voltlog/VoltHub7/schematic_volthub7_revA.pdf

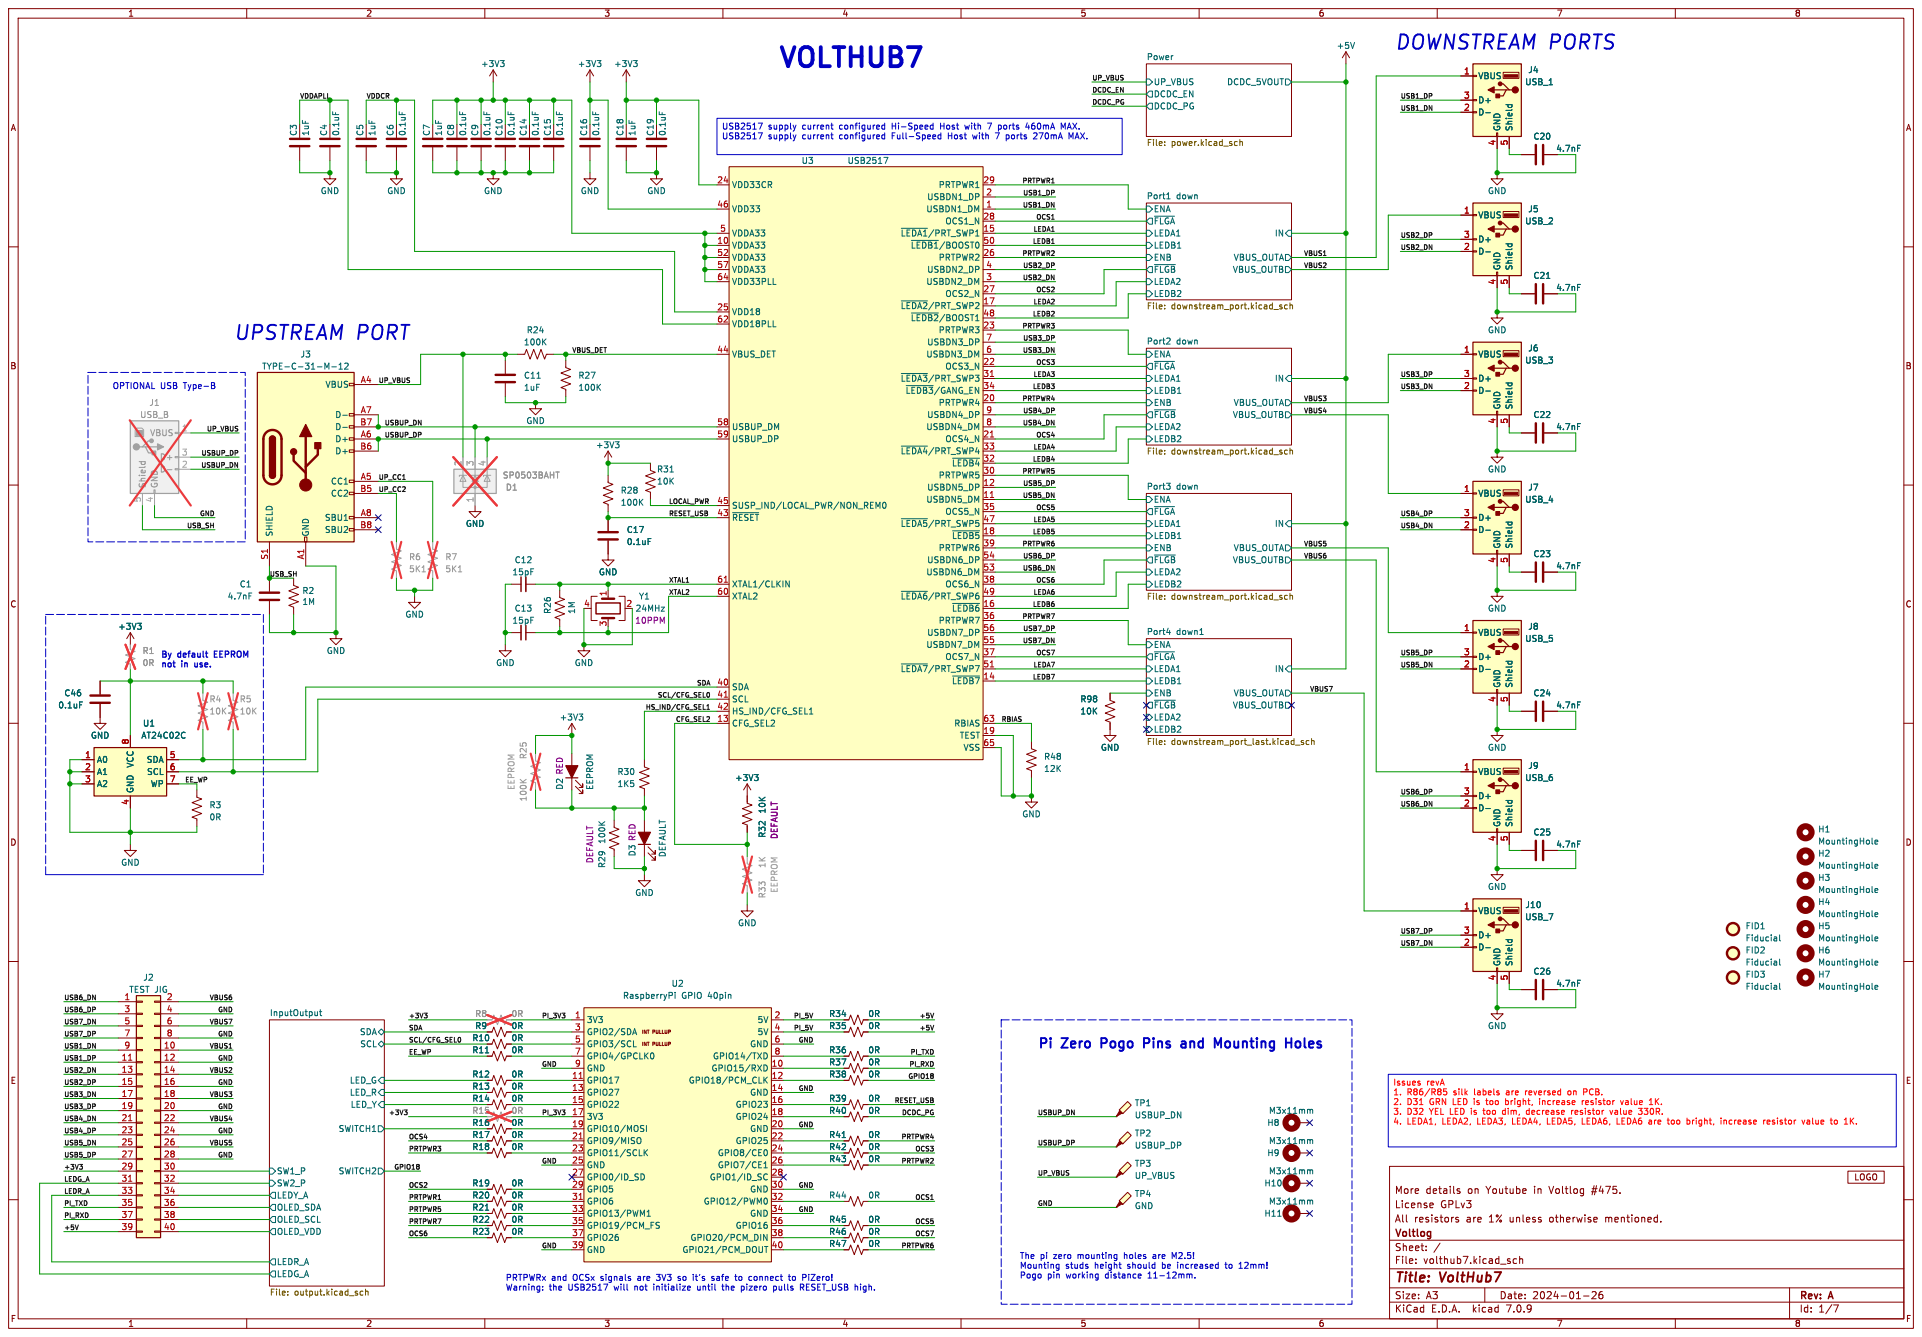
[picture p1: page 1]

DCDC_5VOUT Power File: power.kicad_sch ENA

4 SDA 5 SCL 6 WP 7 VCC

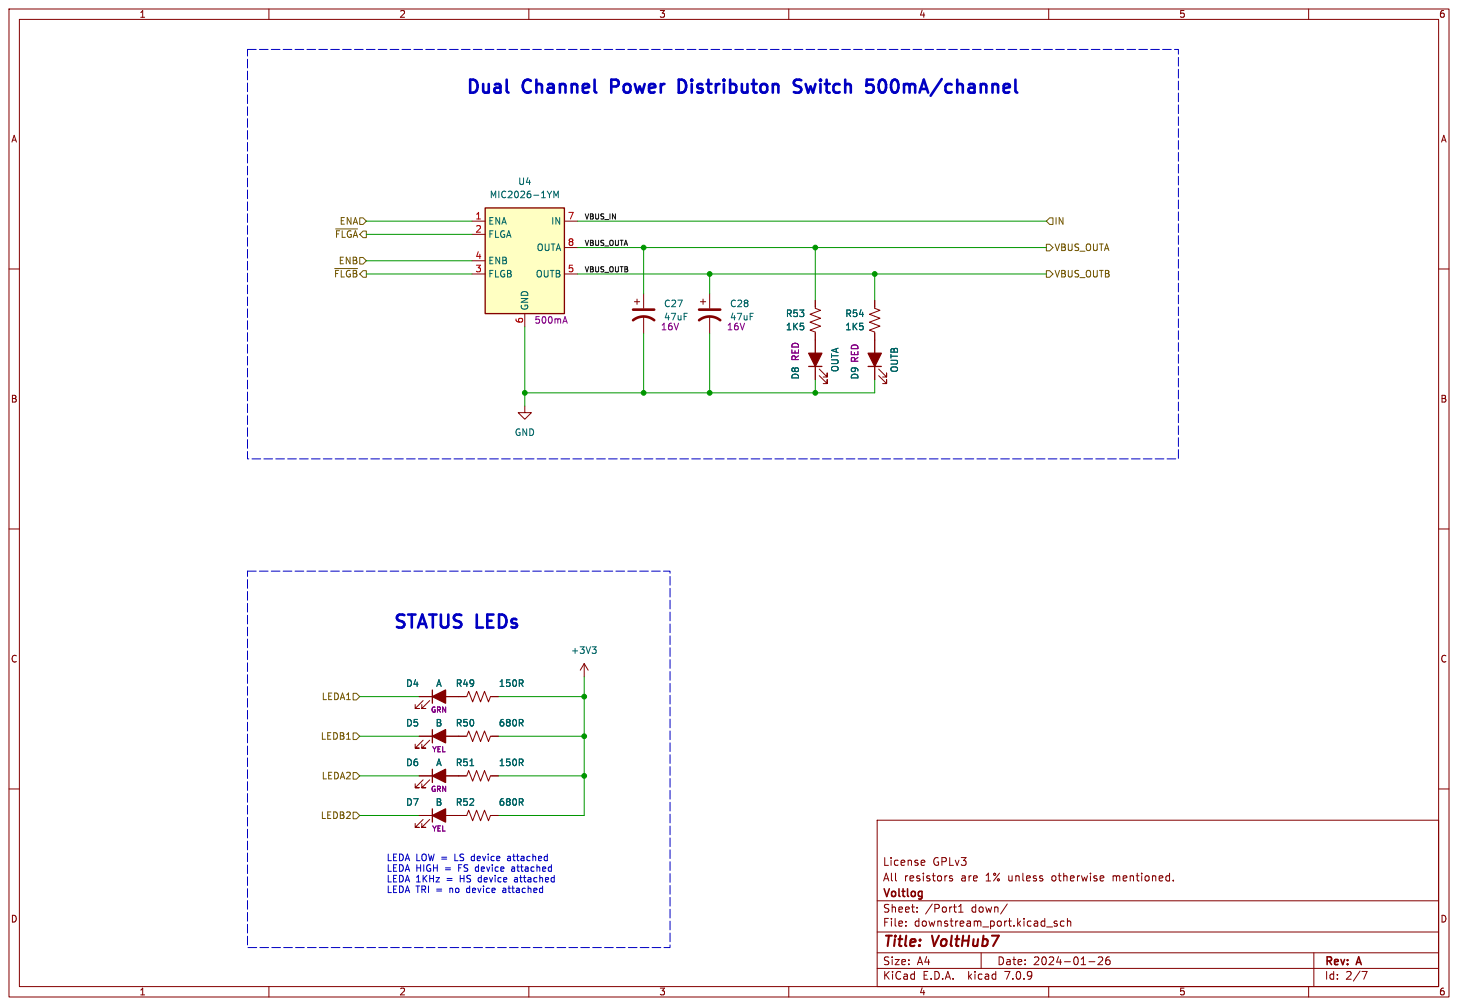
[picture p2: page 2]

LEDA LOW = LS device attached
LEDA HIGH = FS device attached
LEDA 1KHz = HS device attached

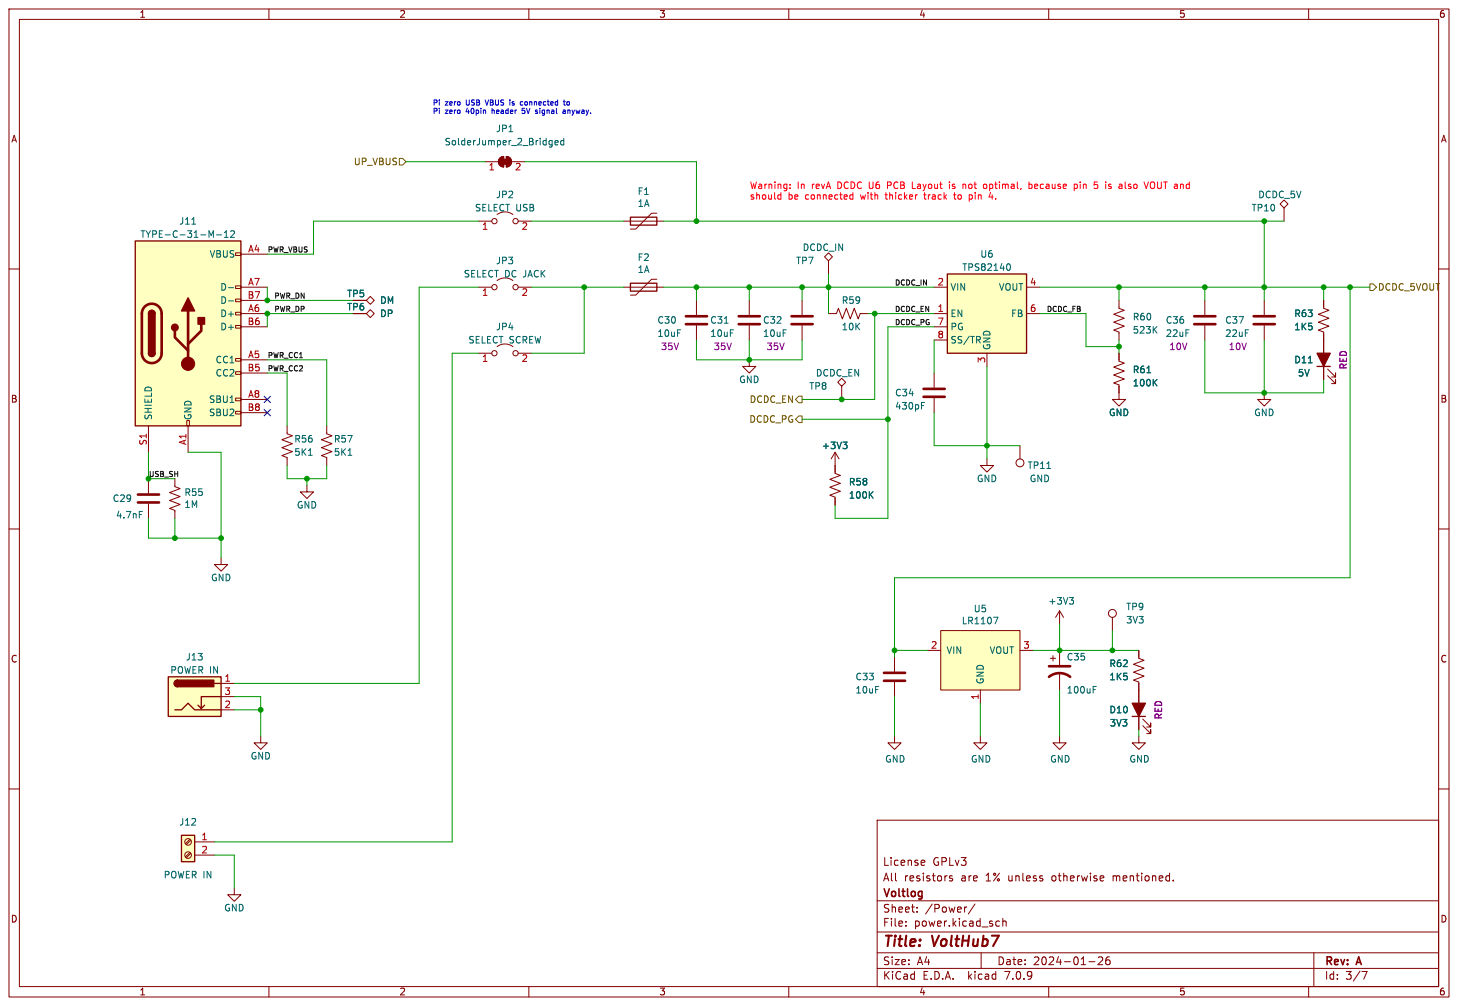
[picture p3: page 3]

3 VOUT 4 FB 6 PG 7 SS/TR 8 U6 TPS82140 R55

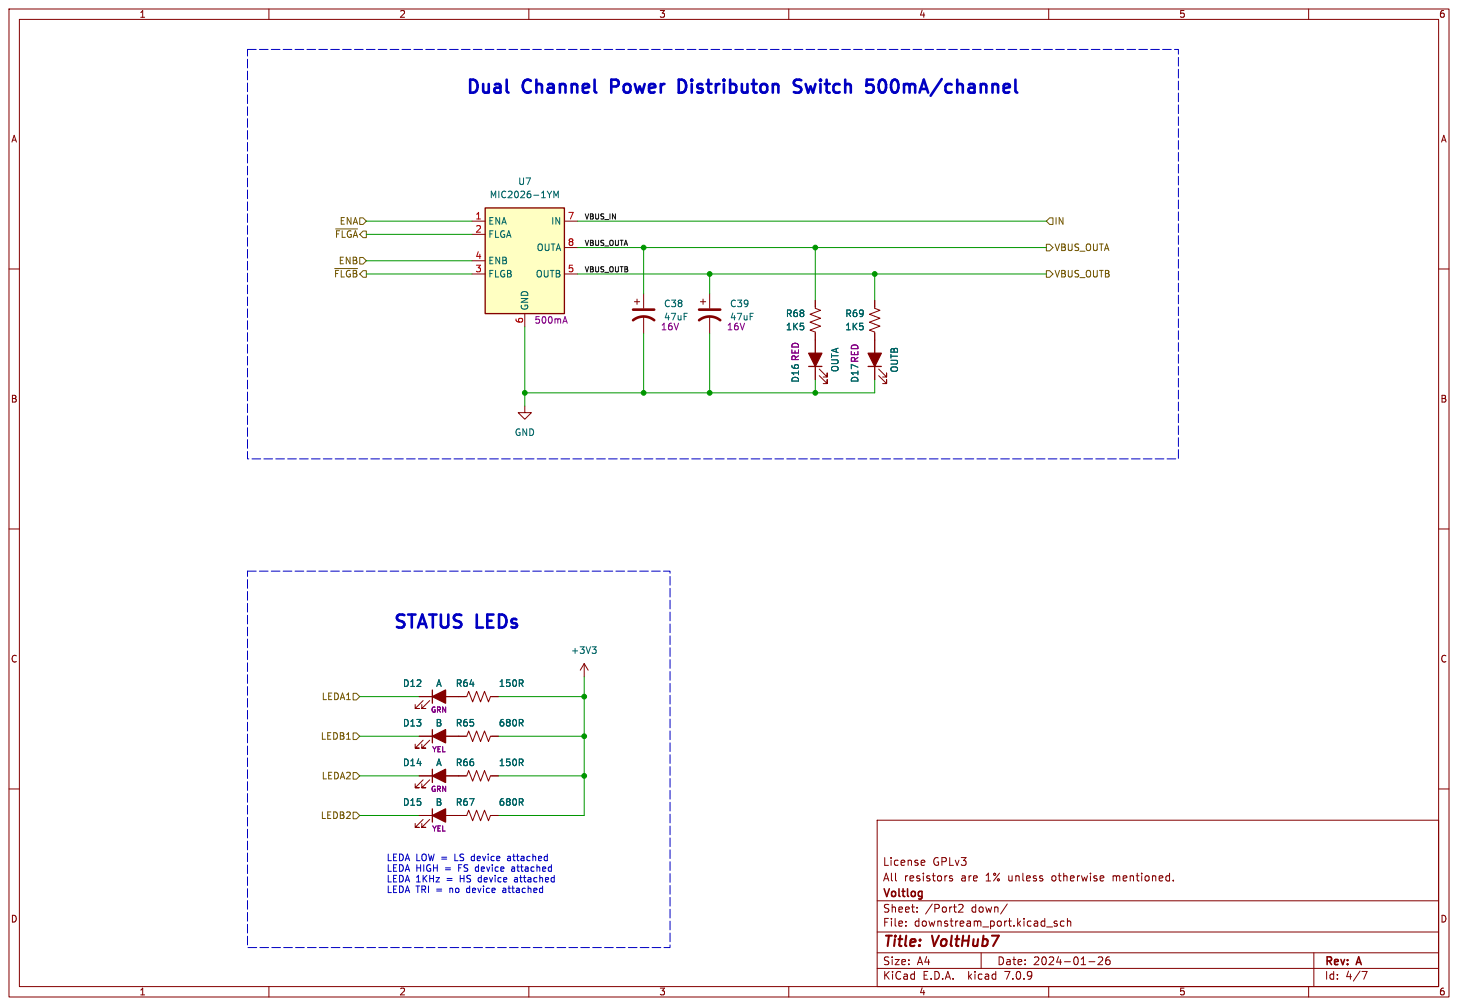
[picture p4: page 4]

LEDA LOW = LS device attached
LEDA HIGH = FS device attached
LEDA 1KHz = HS device attached

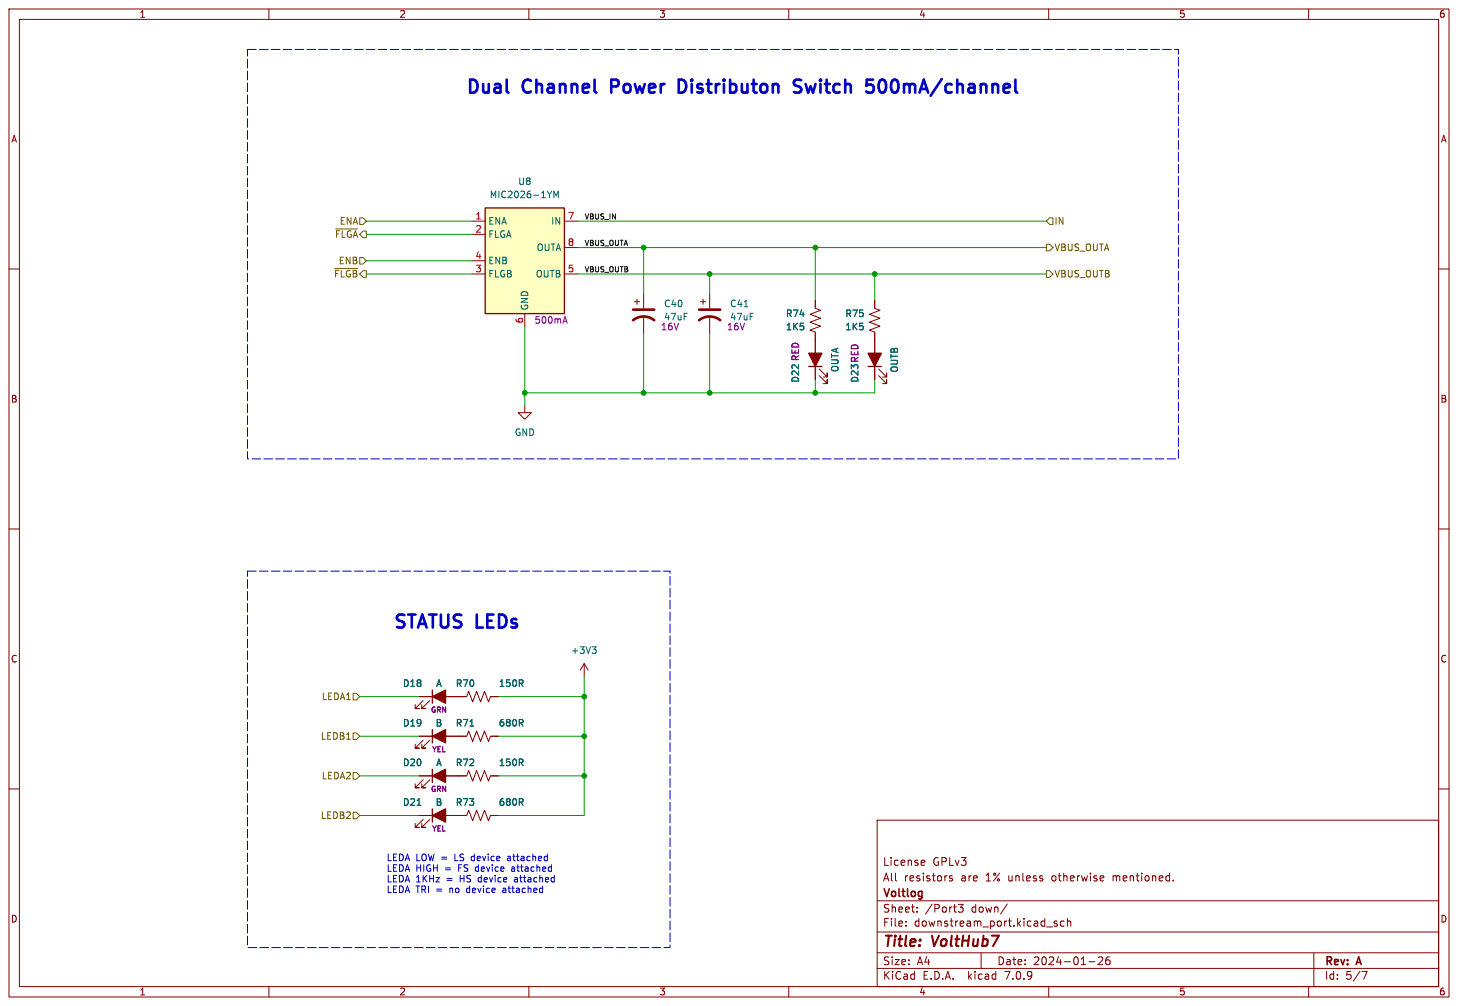
[picture p5: page 5]

LEDA LOW = LS device attached
LEDA HIGH = FS device attached
LEDA 1KHz = HS device attached

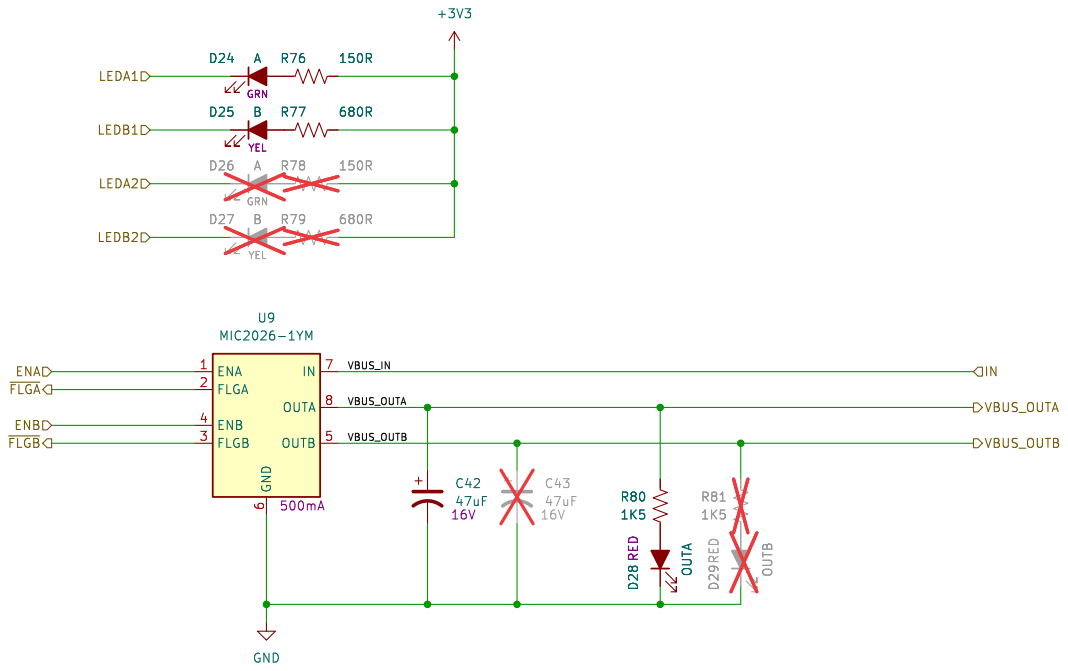
[picture p6: page 6]

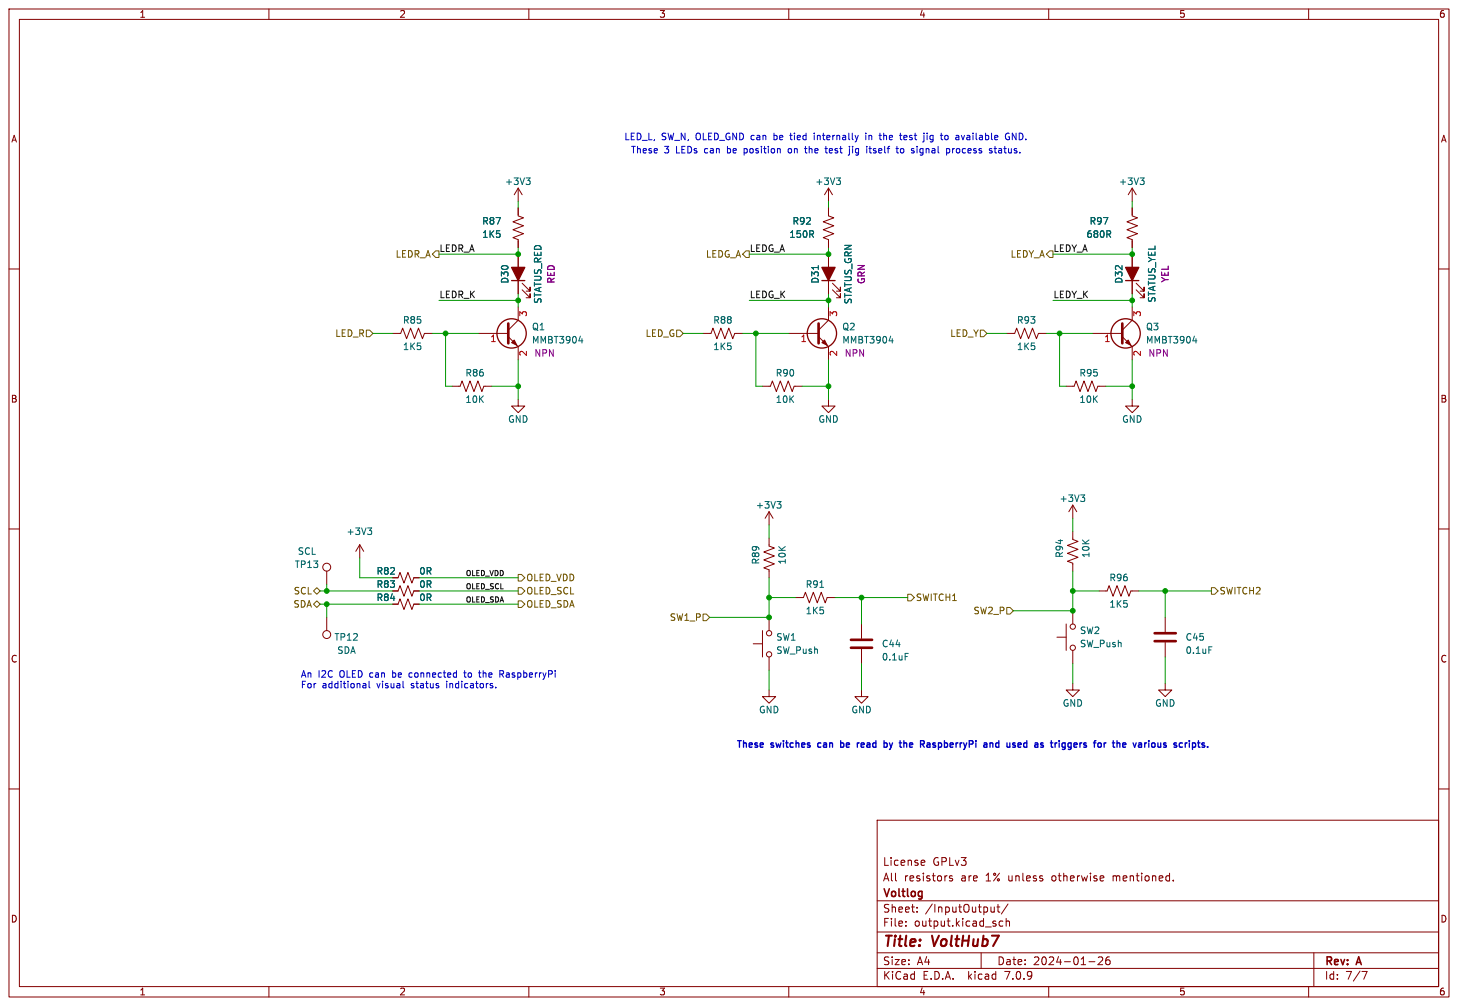
[picture p7: page 7]

File: output.kicad_sch Sheet: /InputOutput/
Id: 7/7 Title: VoltHub7
