voltlog/VoltHub7/volthub7.kicad_pcb

## KiCad design volthub7.kicad_pcb (2024-02-27)

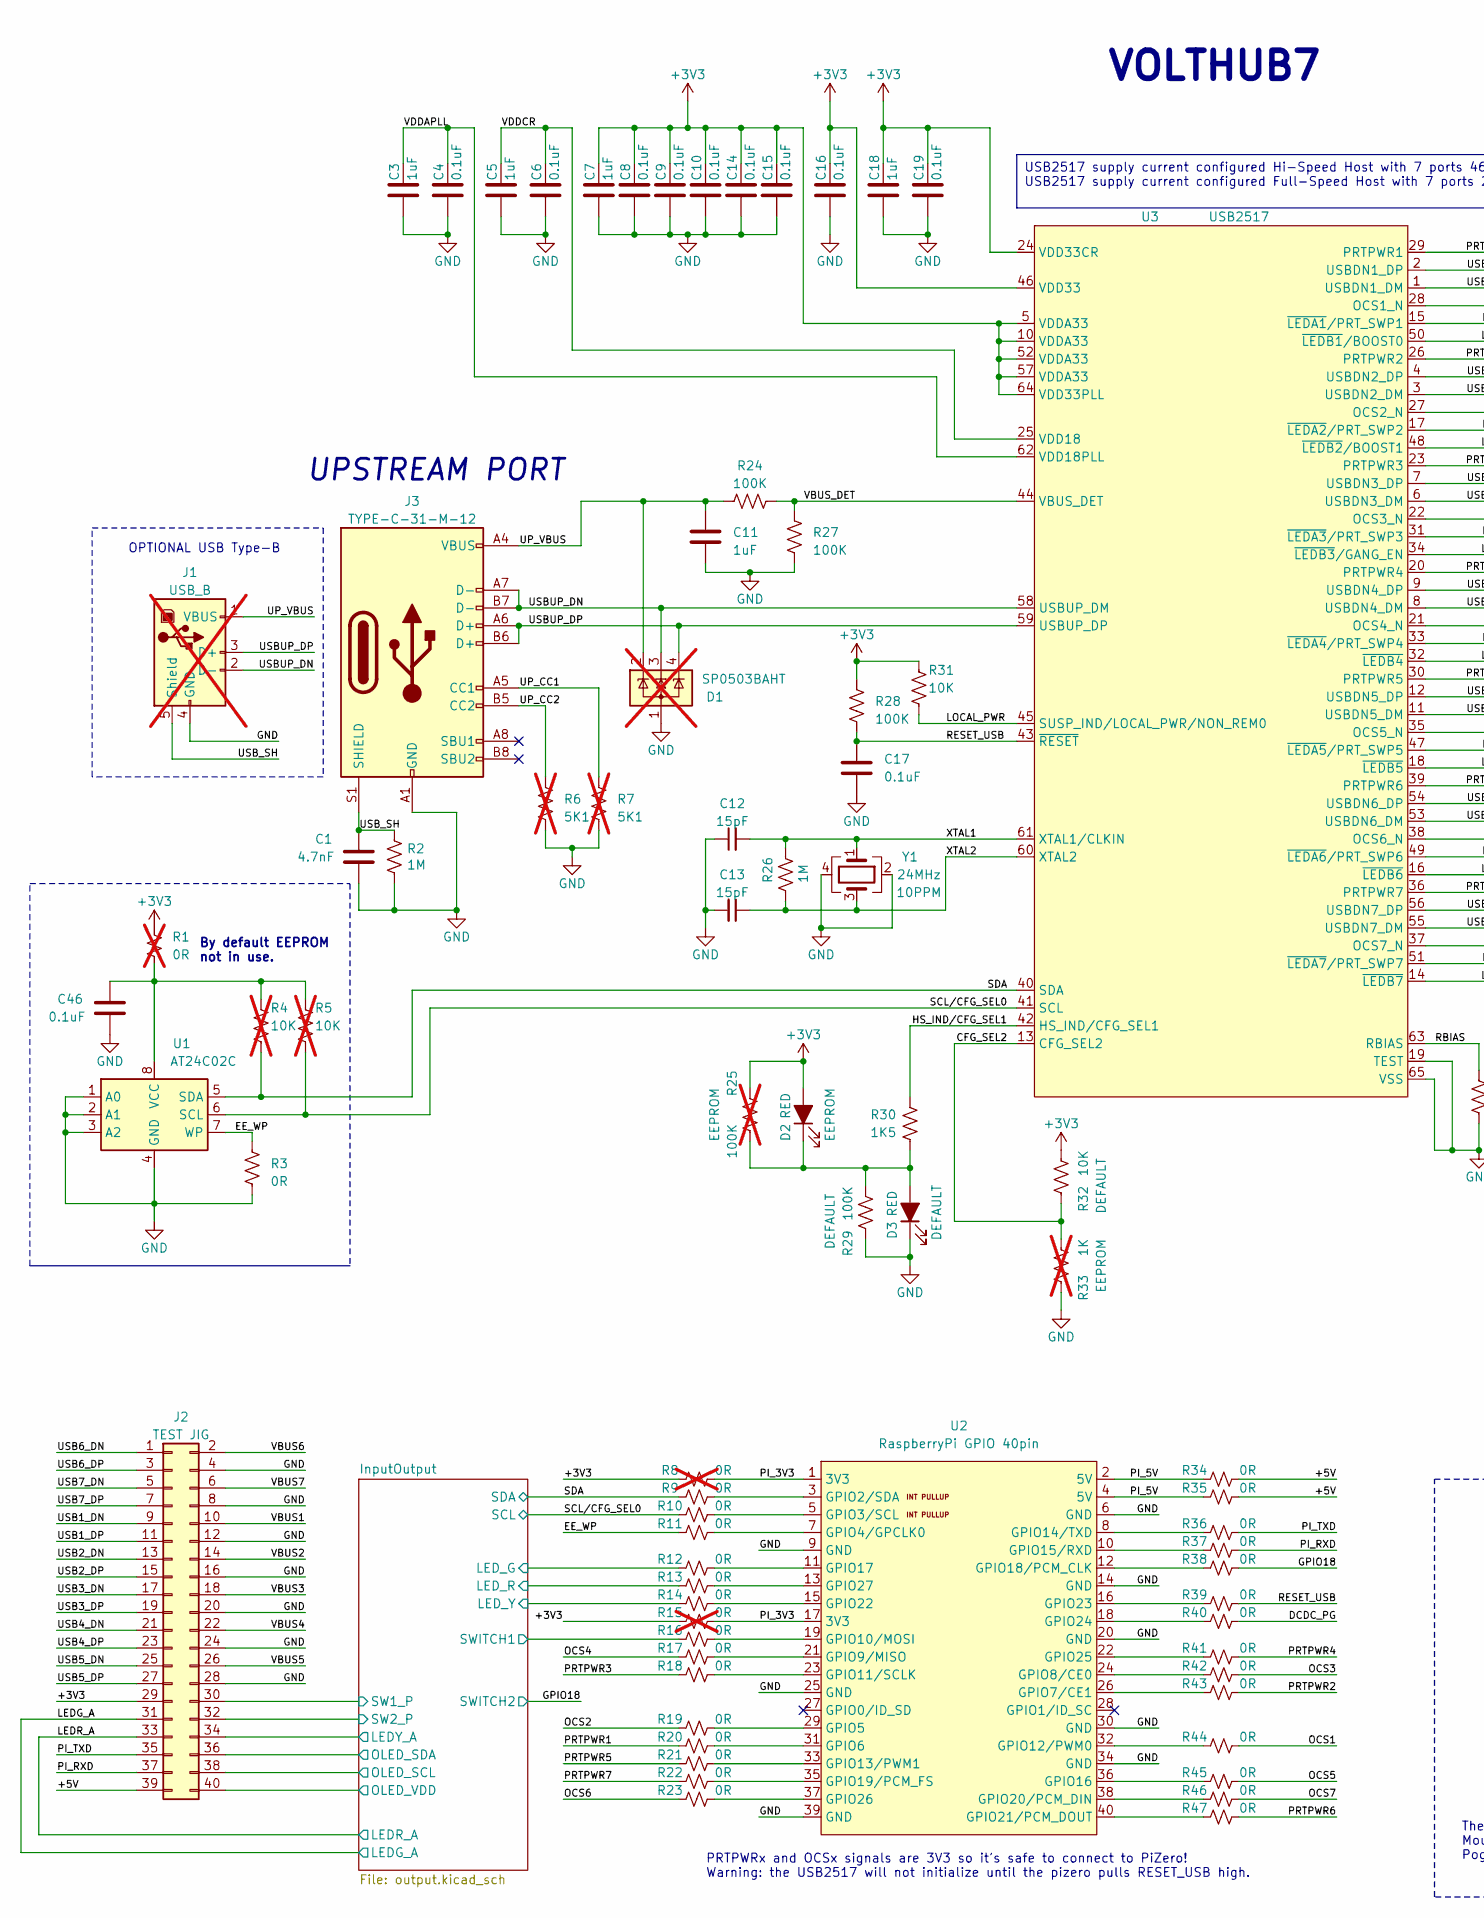
[picture p8: schematic volthub7.kicad_sch, part in row 1, column 1]

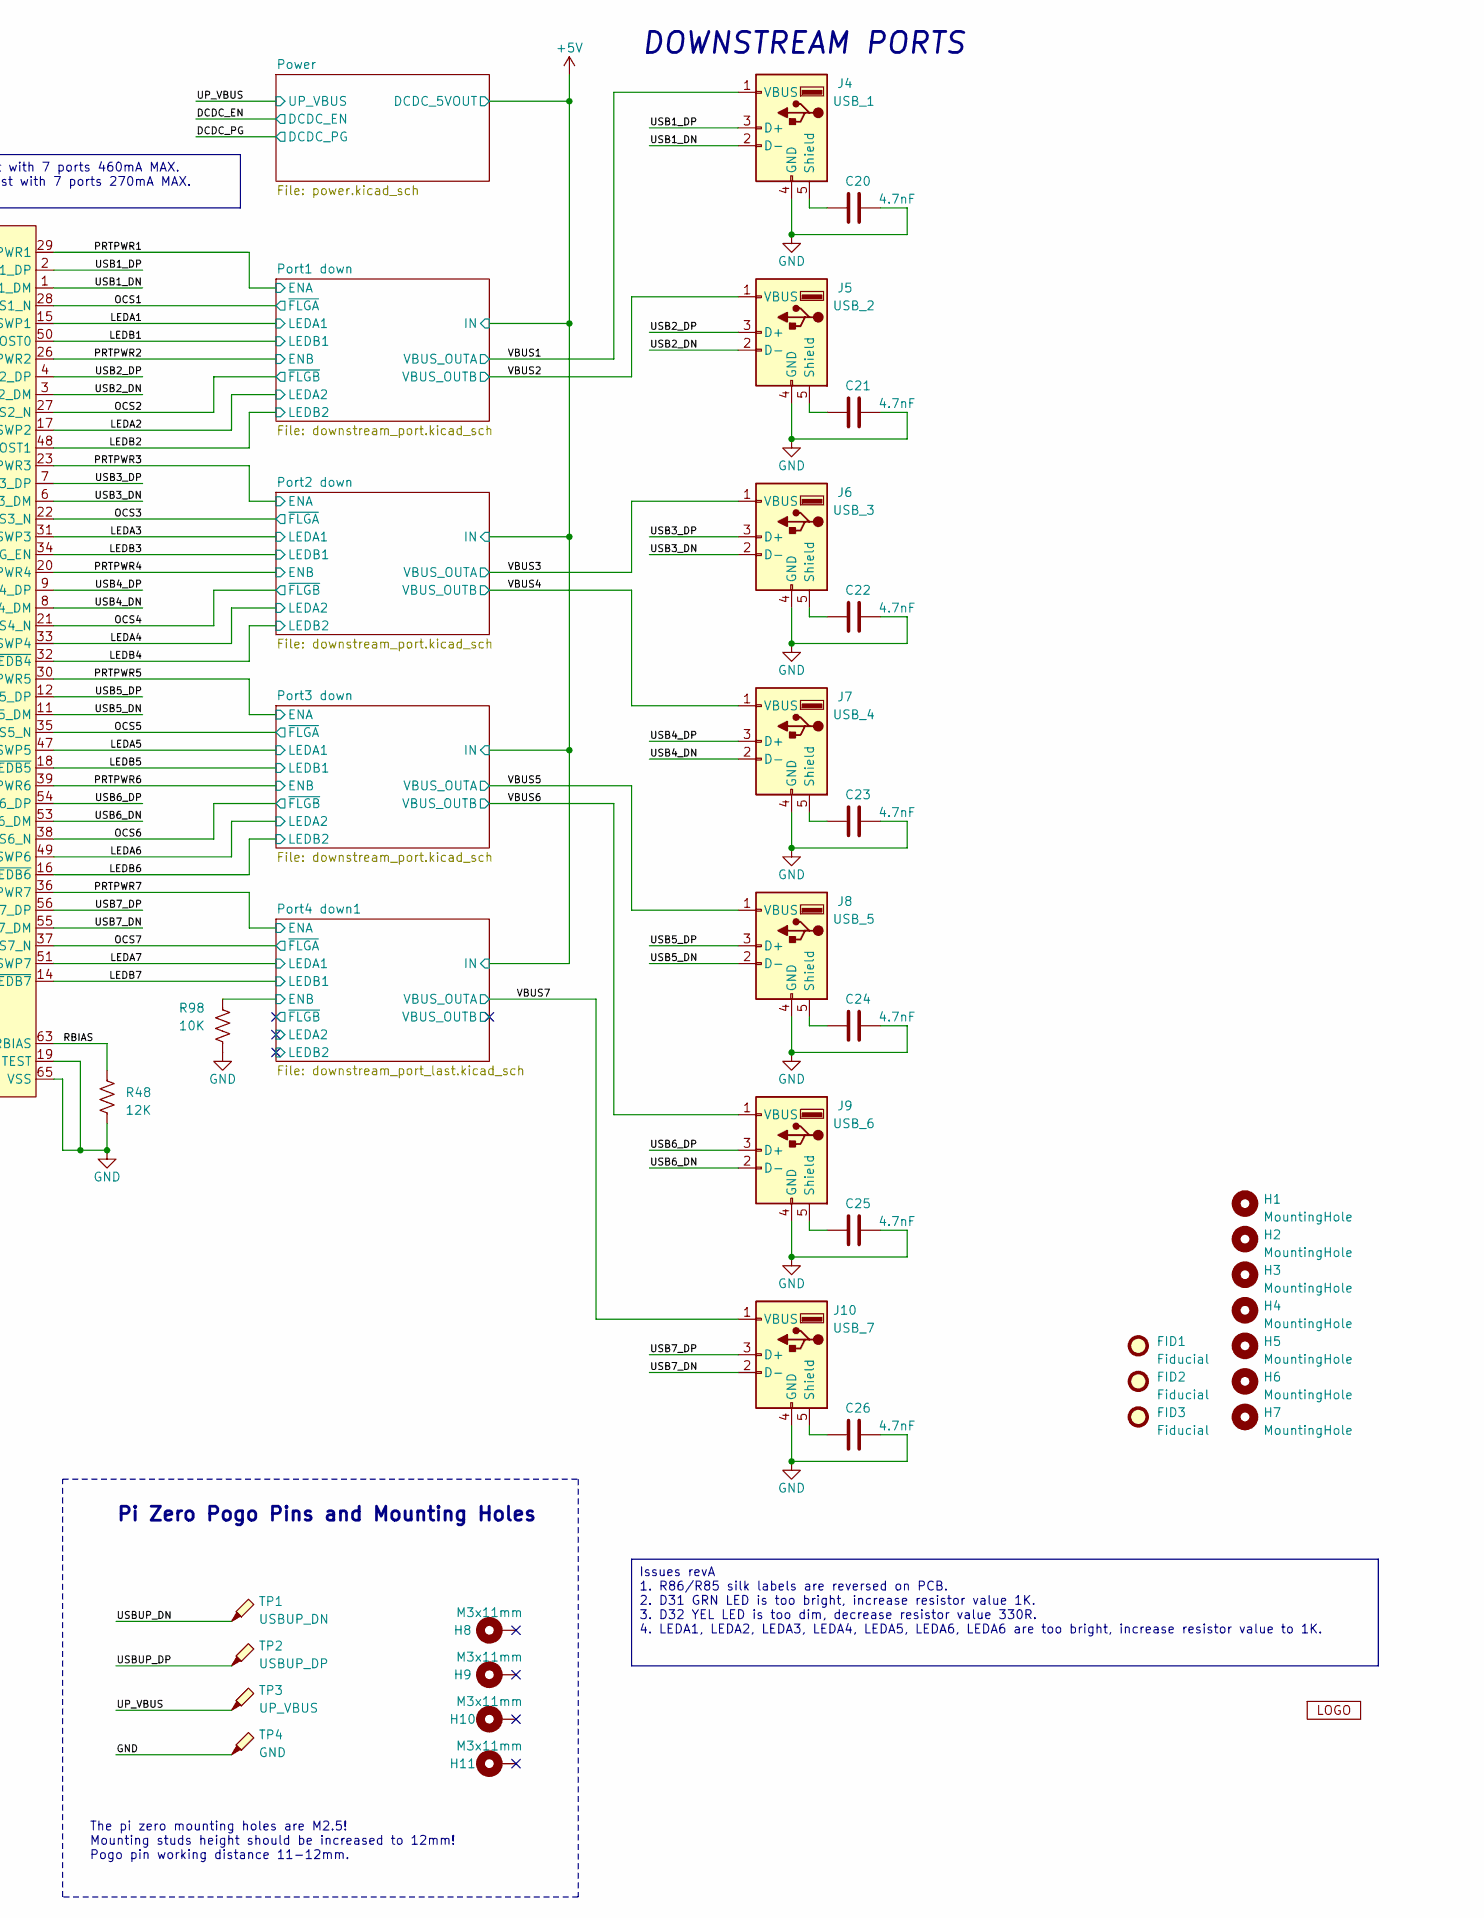
[picture p9: schematic volthub7.kicad_sch, part in row 1, column 2]

Parts:
C1: 4.7nF; C_1206_3216Metric; LCSC C107198
C3, C5, C7, C11, C18: 1uF; C_0603_1608Metric
C4, C6, C8, C9, C10, C14, C15, C16, C17, C19, C46: 0.1uF; C_0603_1608Metric; LCSC C14663
C12, C13: 15pF; C_0603_1608Metric; LCSC C1644
C20, C21, C22, C23, C24, C25, C26: 4.7nF; C_1206_3216Metric; LCSC C24497
D1: SP0503BAHT; SOT-143; LCSC C2682275; not fitted
D2: EEPROM; LED_0603_1608Metric; LCSC C193902
D3: DEFAULT; LED_0603_1608Metric; LCSC C193902
FID1, FID2, FID3: Fiducial; Fiducial_0.5mm_Mask1mm
H1, H2, H3, H4, H5, H6, H7: MountingHole; MountingHole_3.2mm_M3
H8, H9, H10, H11: M3x11mm; SMTSO30100CTJ; LCSC C2916372
J1: USB_B; USB_B_Lumberg_2411_02_Horizontal; LCSC C530600; not fitted
J2: TEST JIG; JST_PHD_B32B-PHDSS_2x20_P2.00mm_Vertical; LCSC C2845630
J3: TYPE-C-31-M-12; USB_C_Receptacle_HRO_TYPE-C-31-M-12; LCSC C165948
J4: USB_1; USB_A_HRO_U-A-24DD-W-5; LCSC C530625
J5: USB_2; USB_A_HRO_U-A-24DD-W-5; LCSC C530625
J6: USB_3; USB_A_HRO_U-A-24DD-W-5; LCSC C530625
J7: USB_4; USB_A_HRO_U-A-24DD-W-5; LCSC C530625
J8: USB_5; USB_A_HRO_U-A-24DD-W-5; LCSC C530625
J9: USB_6; USB_A_HRO_U-A-24DD-W-5; LCSC C530625
J10: USB_7; USB_A_HRO_U-A-24DD-W-5; LCSC C530625
R1, R8, R15: 0R; R_0603_1608Metric; LCSC C21189; not fitted
R2: 1M; R_1206_3216Metric
R3, R9, R10, R11, R12, R13, R14, R16, R17, R18, R19, R20, R21, R22, R23, R34, R35, R36, R37, R38, R39, R40, R41, R42, R43, R44, R45, R46, R47: 0R; R_0603_1608Metric; LCSC C21189
R4, R5: 10K; R_0603_1608Metric; LCSC C25804; not fitted
R6, R7: 5K1; R_0603_1608Metric; not fitted
R24, R27, R28, R29: 100K; R_0603_1608Metric; LCSC C25803
R25: 100K; R_0603_1608Metric; LCSC C25803; not fitted
R26: 1M; R_0603_1608Metric; LCSC C22935
R30: 1K5; R_0603_1608Metric; LCSC C21190
R31, R32, R98: 10K; R_0603_1608Metric; LCSC C25804
R33: 1K; R_0603_1608Metric; LCSC C21190; not fitted
R48: 12K; R_0603_1608Metric; LCSC C22790
TP1: USBUP_DN; Pogo_pin_YZ87615160P-01; LCSC C5157295
TP2: USBUP_DP; Pogo_pin_YZ87615160P-01; LCSC C5157295
TP3: UP_VBUS; Pogo_pin_YZ87615160P-01; LCSC C5157295
TP4: GND; Pogo_pin_YZ87615160P-01; LCSC C5157295
U1: AT24C02C; SOIC-8_3.9x4.9mm_P1.27mm; LCSC C6203
U2: RaspberryPi GPIO 40pin; RaspberryPi_Zero2W_40Pin
U3: USB2517; QFN-64-1EP_9x9mm_P0.5mm_EP4.7x4.7mm; LCSC C1521556
V1: VOLTLOG_LOGO; voltlog_mask_5mm
Y1: 24MHz; Crystal_SMD_SeikoEpson_TSX3225-4Pin_3.2x2.5mm; Tolerance 10PPM; LCSC C89577

Connections:
+3V3: C7.1, C8.1, C9.1, C10.1, C14.1, C15.1, C16.1, C18.1, C19.1, D2.2 (A), J2.29, R1.2, R8.1, R15.1, R25.1, R28.2, R31.2, R32.2, U3.5 (VDDA33), U3.10 (VDDA33), U3.24 (VDD33CR), U3.46 (VDD33), U3.52 (VDDA33), U3.57 (VDDA33), U3.64 (VDD33PLL); also elsewhere on the board
+5V: J2.39, R34.2, R35.2; also elsewhere on the board
/CFG_SEL2: R32.1, R33.2, U3.13 (CFG_SEL2)
/DCDC_PG: R40.2; also elsewhere on the board
/EE_WP: R3.2, R11.1, U1.7 (WP)
/GPIO18: R38.2; also elsewhere on the board
/HS_IND/CFG_SEL1: R30.2, U3.42 (HS_IND/CFG_SEL1)
/LEDA1: U3.15 (~LEDA1/PRT_SWP1); also elsewhere on the board
/LEDA2: U3.17 (~LEDA2/PRT_SWP2); also elsewhere on the board
/LEDA3: U3.31 (~LEDA3/PRT_SWP3); also elsewhere on the board
/LEDA4: U3.33 (~LEDA4/PRT_SWP4); also elsewhere on the board
/LEDA5: U3.47 (~LEDA5/PRT_SWP5); also elsewhere on the board
/LEDA6: U3.49 (~LEDA6/PRT_SWP6); also elsewhere on the board
/LEDA7: U3.51 (~LEDA7/PRT_SWP7); also elsewhere on the board
/LEDB1: U3.50 (~LEDB1/BOOST0); also elsewhere on the board
/LEDB2: U3.48 (~LEDB2/BOOST1); also elsewhere on the board
/LEDB3: U3.34 (~LEDB3/GANG_EN); also elsewhere on the board
/LEDB4: U3.32 (~LEDB4); also elsewhere on the board
/LEDB5: U3.18 (~LEDB5); also elsewhere on the board
/LEDB6: U3.16 (~LEDB6); also elsewhere on the board
/LEDB7: U3.14 (~LEDB7); also elsewhere on the board
/LEDG_A: J2.31; also elsewhere on the board
/LEDR_A: J2.33; also elsewhere on the board
/LOCAL_PWR: R31.1, U3.45 (SUSP_IND/LOCAL_PWR/NON_REM0)
/OCS1: R44.2, U3.28 (OCS1_N); also elsewhere on the board
/OCS2: R19.1, U3.27 (OCS2_N); also elsewhere on the board
/OCS3: R42.2, U3.22 (OCS3_N); also elsewhere on the board
/OCS4: R17.1, U3.21 (OCS4_N); also elsewhere on the board
/OCS5: R45.2, U3.35 (OCS5_N); also elsewhere on the board
/OCS6: R23.1, U3.38 (OCS6_N); also elsewhere on the board
/OCS7: R46.2, U3.37 (OCS7_N); also elsewhere on the board
/Output/LEDY_A: J2.34; also elsewhere on the board
/Output/LED_G: R12.1; also elsewhere on the board
/Output/LED_R: R13.1; also elsewhere on the board
/Output/LED_Y: R14.1; also elsewhere on the board
/Output/OLED_SCL: J2.38; also elsewhere on the board
/Output/OLED_SDA: J2.36; also elsewhere on the board
/Output/OLED_VDD: J2.40; also elsewhere on the board
/Output/SW1_P: J2.30; also elsewhere on the board
/Output/SW2_P: J2.32; also elsewhere on the board
/Output/SWITCH1: R16.1; also elsewhere on the board
/PI_3V3: R8.2, R15.2, U2.1 (3V3), U2.17 (3V3)
/PI_5V: R34.1, R35.1, U2.2 (5V), U2.4 (5V)
/PI_RXD: J2.37, R37.2
/PI_TXD: J2.35, R36.2
/PRTPWR1: R20.1, U3.29 (PRTPWR1); also elsewhere on the board
/PRTPWR2: R43.2, U3.26 (PRTPWR2); also elsewhere on the board
/PRTPWR3: R18.1, U3.23 (PRTPWR3); also elsewhere on the board
/PRTPWR4: R41.2, U3.20 (PRTPWR4); also elsewhere on the board
/PRTPWR5: R21.1, U3.30 (PRTPWR5); also elsewhere on the board
/PRTPWR6: R47.2, U3.39 (PRTPWR6); also elsewhere on the board
/PRTPWR7: R22.1, U3.36 (PRTPWR7); also elsewhere on the board
/Port4 down1/ENB: R98.2; also elsewhere on the board
/RBIAS: R48.2, U3.63 (RBIAS)
/RESET_USB: C17.1, R28.1, R39.2, U3.43 (~RESET)
/SCL/CFG_SEL0: R5.1, R10.1, U1.6 (SCL), U3.41 (SCL); also elsewhere on the board
/SDA: R4.1, R9.1, U1.5 (SDA), U3.40 (SDA); also elsewhere on the board
/UP_CC1: J3.A5 (CC1), R7.2
/UP_CC2: J3.B5 (CC2), R6.2
/UP_VBUS: C11.1, D1.2 (K), J1.1 (VBUS), J3.A4 (VBUS), J3.A9 (VBUS), J3.B4 (VBUS), J3.B9 (VBUS), R24.1, TP3.1; also elsewhere on the board
/USB1_DN: J2.9, J4.2 (D-), U3.1 (USBDN1_DM)
/USB1_DP: J2.11, J4.3 (D+), U3.2 (USBDN1_DP)
/USB2_DN: J2.13, J5.2 (D-), U3.3 (USBDN2_DM)
/USB2_DP: J2.15, J5.3 (D+), U3.4 (USBDN2_DP)
/USB3_DN: J2.17, J6.2 (D-), U3.6 (USBDN3_DM)
/USB3_DP: J2.19, J6.3 (D+), U3.7 (USBDN3_DP)
/USB4_DN: J2.21, J7.2 (D-), U3.8 (USBDN4_DM)
/USB4_DP: J2.23, J7.3 (D+), U3.9 (USBDN4_DP)
/USB5_DN: J2.25, J8.2 (D-), U3.11 (USBDN5_DM)
/USB5_DP: J2.27, J8.3 (D+), U3.12 (USBDN5_DP)
/USB6_DN: J2.1, J9.2 (D-), U3.53 (USBDN6_DM)
/USB6_DP: J2.3, J9.3 (D+), U3.54 (USBDN6_DP)
/USB7_DN: J2.5, J10.2 (D-), U3.55 (USBDN7_DM)
/USB7_DP: J2.7, J10.3 (D+), U3.56 (USBDN7_DP)
/USBUP_DN: D1.3 (K), J1.2 (D-), J3.A7 (D-), J3.B7 (D-), TP1.1, U3.58 (USBUP_DM)
/USBUP_DP: D1.4 (K), J1.3 (D+), J3.A6 (D+), J3.B6 (D+), TP2.1, U3.59 (USBUP_DP)
/VBUS1: J2.10, J4.1 (VBUS); also elsewhere on the board
/VBUS2: J2.14, J5.1 (VBUS); also elsewhere on the board
/VBUS3: J2.18, J6.1 (VBUS); also elsewhere on the board
/VBUS4: J2.22, J7.1 (VBUS); also elsewhere on the board
/VBUS5: J2.26, J8.1 (VBUS); also elsewhere on the board
/VBUS6: J2.2, J9.1 (VBUS); also elsewhere on the board
/VBUS7: J2.6, J10.1 (VBUS); also elsewhere on the board
/VBUS_DET: R24.2, R27.2, U3.44 (VBUS_DET)
/VDDAPLL: C3.1, C4.1, U3.62 (VDD18PLL)
/VDDCR: C5.1, C6.1, U3.25 (VDD18)
/XTAL1: C12.2, R26.2, U3.61 (XTAL1/CLKIN), Y1.1
/XTAL2: C13.1, R26.1, U3.60 (XTAL2), Y1.3
GND: C1.2, C3.2, C4.2, C5.2, C6.2, C7.2, C8.2, C9.2, C10.2, C11.2, C12.1, C13.2, C14.2, C15.2, C16.2, C17.2, C18.2, C19.2, C20.2, C21.2, C22.2, C23.2, C24.2, C25.2, C26.2, D1.1 (A), D3.1 (K), J1.4 (GND), J2.4, J2.8, J2.12, J2.16, J2.20, J2.24, J2.28, J3.A1 (GND), J3.A12 (GND), J3.B1 (GND), J3.B12 (GND), J4.4 (GND), J5.4 (GND), J6.4 (GND), J7.4 (GND), J8.4 (GND), J9.4 (GND), J10.4 (GND), R2.2, R3.1, R6.1, R7.1, R27.1, R29.2, R33.1, R48.1, R98.1, TP4.1, U1.1 (A0), U1.2 (A1), U1.3 (A2), U1.4 (GND), U2.6 (GND), U2.9 (GND), U2.14 (GND), U2.20 (GND), U2.25 (GND), U2.30 (GND), U2.34 (GND), U2.39 (GND), U3.19 (TEST), U3.65 (VSS), Y1.2, Y1.4; also elsewhere on the board
unnamed: D2.1 (K), D3.2 (A), R25.2, R29.1, R30.1
unnamed: C20.1, J4.5 (Shield)
unnamed: C21.1, J5.5 (Shield)
unnamed: C22.1, J6.5 (Shield)
unnamed: C23.1, J7.5 (Shield)
unnamed: C24.1, J8.5 (Shield)
unnamed: C25.1, J9.5 (Shield)
unnamed: C26.1, J10.5 (Shield)
unnamed: R9.2, U2.3 (GPIO2/SDA)
unnamed: R10.2, U2.5 (GPIO3/SCL)
unnamed: R11.2, U2.7 (GPIO4/GPCLK0)
unnamed: R19.2, U2.29 (GPIO5)
unnamed: R20.2, U2.31 (GPIO6)
unnamed: R43.1, U2.26 (GPIO7/CE1)
unnamed: R42.1, U2.24 (GPIO8/CE0)
unnamed: R17.2, U2.21 (GPIO9/MISO)
unnamed: R16.2, U2.19 (GPIO10/MOSI)
unnamed: R18.2, U2.23 (GPIO11/SCLK)
unnamed: R44.1, U2.32 (GPIO12/PWM0)
unnamed: R21.2, U2.33 (GPIO13/PWM1)
unnamed: R36.1, U2.8 (GPIO14/TXD)
unnamed: R37.1, U2.10 (GPIO15/RXD)
unnamed: R45.1, U2.36 (GPIO16)
unnamed: R12.2, U2.11 (GPIO17)
unnamed: R38.1, U2.12 (GPIO18/PCM_CLK)
unnamed: R22.2, U2.35 (GPIO19/PCM_FS)
unnamed: R46.1, U2.38 (GPIO20/PCM_DIN)
unnamed: R47.1, U2.40 (GPIO21/PCM_DOUT)
unnamed: R14.2, U2.15 (GPIO22)
unnamed: R39.1, U2.16 (GPIO23)
unnamed: R40.1, U2.18 (GPIO24)
unnamed: R41.1, U2.22 (GPIO25)
unnamed: R23.2, U2.37 (GPIO26)
unnamed: R13.2, U2.13 (GPIO27)

Notes on the sheet:
USB2517 supply current configured Hi-Speed Host with 7 ports 460mA MAX. USB2517 supply current configured Full-Speed Host with 7 ports 270mA MAX.
Issues revA 1. R86/R85 silk labels are reversed on PCB. 2. D31 GRN LED is too bright, increase resistor value 1K. 3. D32 YEL LED is too dim, decrease resistor value 330R. 4. LEDA1, LEDA2, LEDA3, LEDA4, LEDA5, LEDA6, LEDA6 are too bright, increase resistor value to 1K.
The pi zero mounting holes are M2.5! Mounting studs height should be increased to 12mm! Pogo pin working distance 11-12mm.
PRTPWRx and OCSx signals are 3V3 so it's safe to connect to PiZero! Warning: the USB2517 will not initialize until the pizero pulls RESET_USB high.
OPTIONAL USB Type-B
UPSTREAM PORT
VOLTHUB7
By default EEPROM not in use.
Pi Zero Pogo Pins and Mounting Holes
DOWNSTREAM PORTS

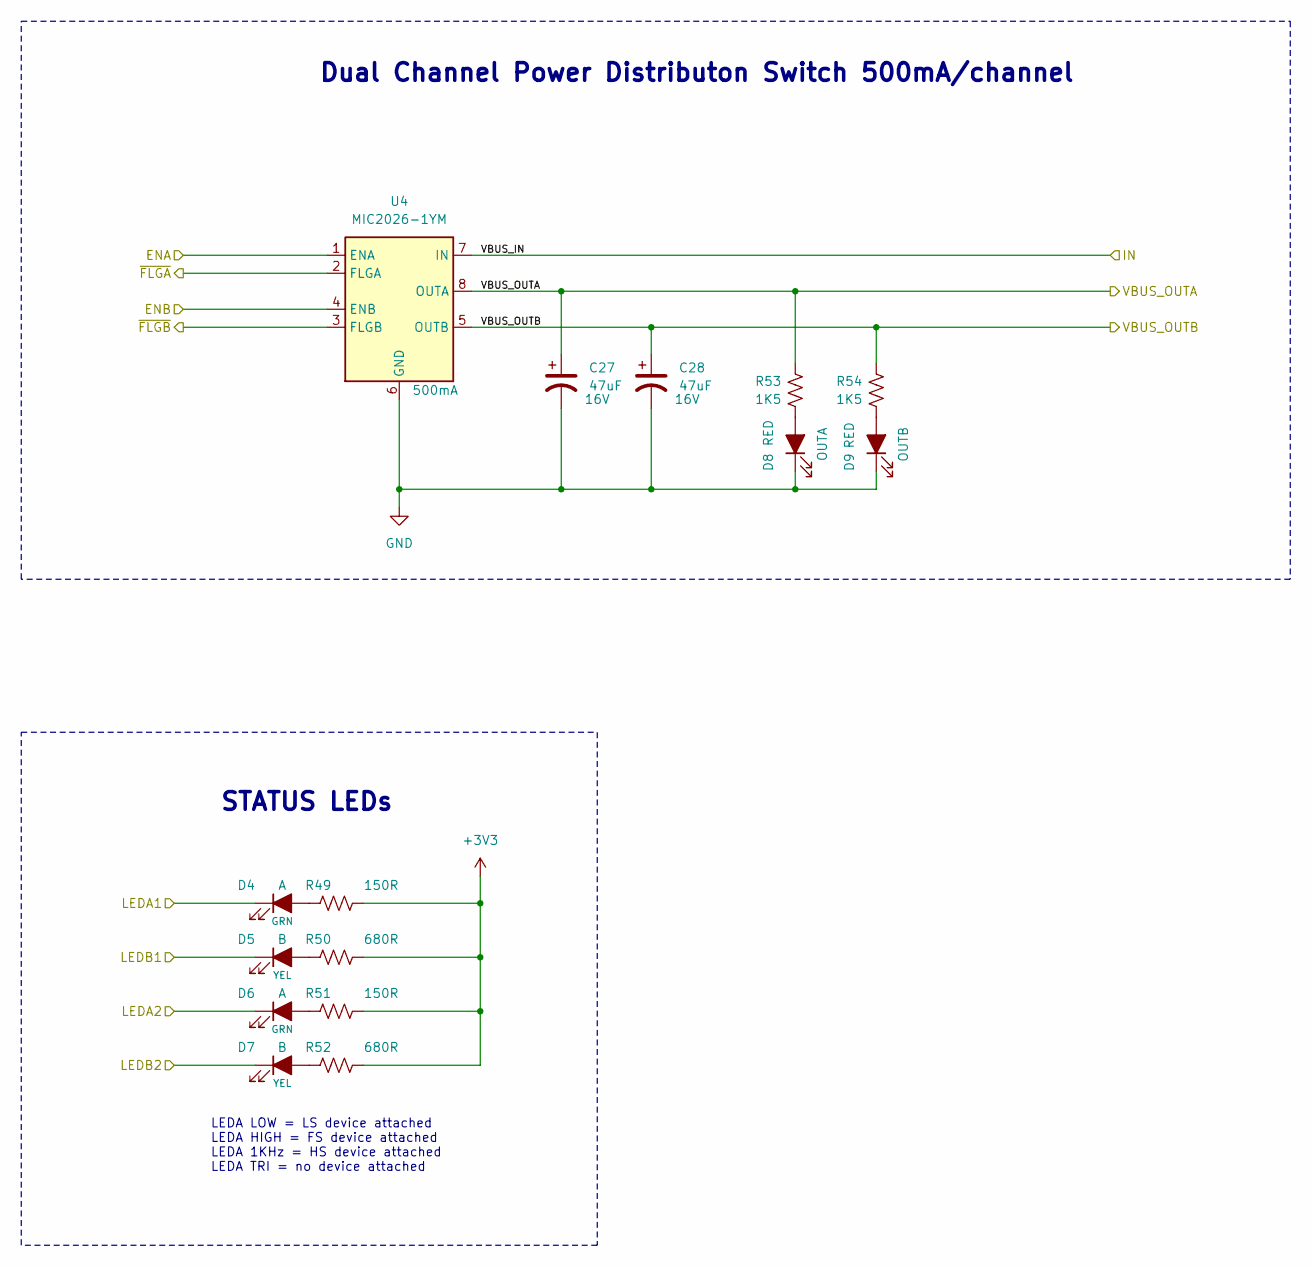
[picture p10: schematic downstream_port.kicad_sch, VoltHub7]

Parts:
C27, C28: 47uF; CP_Elec_6.3x5.3; Voltage 16V; LCSC C249535
D4, D6: A; LED_0603_1608Metric; LCSC C84267
D5, D7: B; LED_0603_1608Metric; LCSC C84268
D8: OUTA; LED_0603_1608Metric; LCSC C193902
D9: OUTB; LED_0603_1608Metric; LCSC C193902
R49, R51: 150R; R_0603_1608Metric; LCSC C22808
R50, R52: 680R; R_0603_1608Metric; LCSC C23228
R53, R54: 1K5; R_0603_1608Metric
U4: MIC2026-1YM; SO-8_3.9x4.9mm_P1.27mm; LCSC C144190

Connections:
+3V3: R49.2, R50.2, R51.2, R52.2; also elsewhere on the board
+5V: U4.7 (IN); also elsewhere on the board
/LEDA1: D4.1 (K); also elsewhere on the board
/LEDA2: D6.1 (K); also elsewhere on the board
/LEDB1: D5.1 (K); also elsewhere on the board
/LEDB2: D7.1 (K); also elsewhere on the board
/OCS1: U4.2 (FLGA); also elsewhere on the board
/OCS2: U4.3 (FLGB); also elsewhere on the board
/PRTPWR1: U4.1 (ENA); also elsewhere on the board
/PRTPWR2: U4.4 (ENB); also elsewhere on the board
/VBUS1: C27.1, R53.2, U4.8 (OUTA); also elsewhere on the board
/VBUS2: C28.1, R54.2, U4.5 (OUTB); also elsewhere on the board
GND: C27.2, C28.2, D8.1 (K), D9.1 (K), U4.6 (GND); also elsewhere on the board
unnamed: D4.2 (A), R49.1
unnamed: D5.2 (A), R50.1
unnamed: D6.2 (A), R51.1
unnamed: D7.2 (A), R52.1
unnamed: D8.2 (A), R53.1
unnamed: D9.2 (A), R54.1

Parts of its further copies:
C38, C39, C40, C41: 47uF; CP_Elec_6.3x5.3; Voltage 16V; LCSC C249535
D12, D14, D18, D20: A; LED_0603_1608Metric; LCSC C84267
D13, D15, D19, D21: B; LED_0603_1608Metric; LCSC C84268
D16, D22: OUTA; LED_0603_1608Metric; LCSC C193902
D17, D23: OUTB; LED_0603_1608Metric; LCSC C193902
R64, R66, R70, R72: 150R; R_0603_1608Metric; LCSC C22808
R65, R67, R71, R73: 680R; R_0603_1608Metric; LCSC C23228
R68, R69, R74, R75: 1K5; R_0603_1608Metric
U7, U8: MIC2026-1YM; SO-8_3.9x4.9mm_P1.27mm; LCSC C144190

Connections of its further copies:
+3V3: R64.2, R65.2, R66.2, R67.2, R70.2, R71.2, R72.2, R73.2; also elsewhere on the board
+5V: U7.7 (IN), U8.7 (IN); also elsewhere on the board
/LEDA3: D12.1 (K); also elsewhere on the board
/LEDA4: D14.1 (K); also elsewhere on the board
/LEDA5: D18.1 (K); also elsewhere on the board
/LEDA6: D20.1 (K); also elsewhere on the board
/LEDB3: D13.1 (K); also elsewhere on the board
/LEDB4: D15.1 (K); also elsewhere on the board
/LEDB5: D19.1 (K); also elsewhere on the board
/LEDB6: D21.1 (K); also elsewhere on the board
/OCS3: U7.2 (FLGA); also elsewhere on the board
/OCS4: U7.3 (FLGB); also elsewhere on the board
/OCS5: U8.2 (FLGA); also elsewhere on the board
/OCS6: U8.3 (FLGB); also elsewhere on the board
/PRTPWR3: U7.1 (ENA); also elsewhere on the board
/PRTPWR4: U7.4 (ENB); also elsewhere on the board
/PRTPWR5: U8.1 (ENA); also elsewhere on the board
/PRTPWR6: U8.4 (ENB); also elsewhere on the board
/VBUS3: C38.1, R68.2, U7.8 (OUTA); also elsewhere on the board
/VBUS4: C39.1, R69.2, U7.5 (OUTB); also elsewhere on the board
/VBUS5: C40.1, R74.2, U8.8 (OUTA); also elsewhere on the board
/VBUS6: C41.1, R75.2, U8.5 (OUTB); also elsewhere on the board
GND: C38.2, C39.2, C40.2, C41.2, D16.1 (K), D17.1 (K), D22.1 (K), D23.1 (K), U7.6 (GND), U8.6 (GND); also elsewhere on the board
unnamed: D12.2 (A), R64.1
unnamed: D13.2 (A), R65.1
unnamed: D14.2 (A), R66.1
unnamed: D15.2 (A), R67.1
unnamed: D16.2 (A), R68.1
unnamed: D17.2 (A), R69.1
unnamed: D18.2 (A), R70.1
unnamed: D19.2 (A), R71.1
unnamed: D20.2 (A), R72.1
unnamed: D21.2 (A), R73.1
unnamed: D22.2 (A), R74.1
unnamed: D23.2 (A), R75.1

Notes on the sheet:
Dual Channel Power Distributon Switch 500mA/channel
STATUS LEDs
LEDA LOW = LS device attached LEDA HIGH = FS device attached LEDA 1KHz = HS device attached LEDA TRI = no device attached

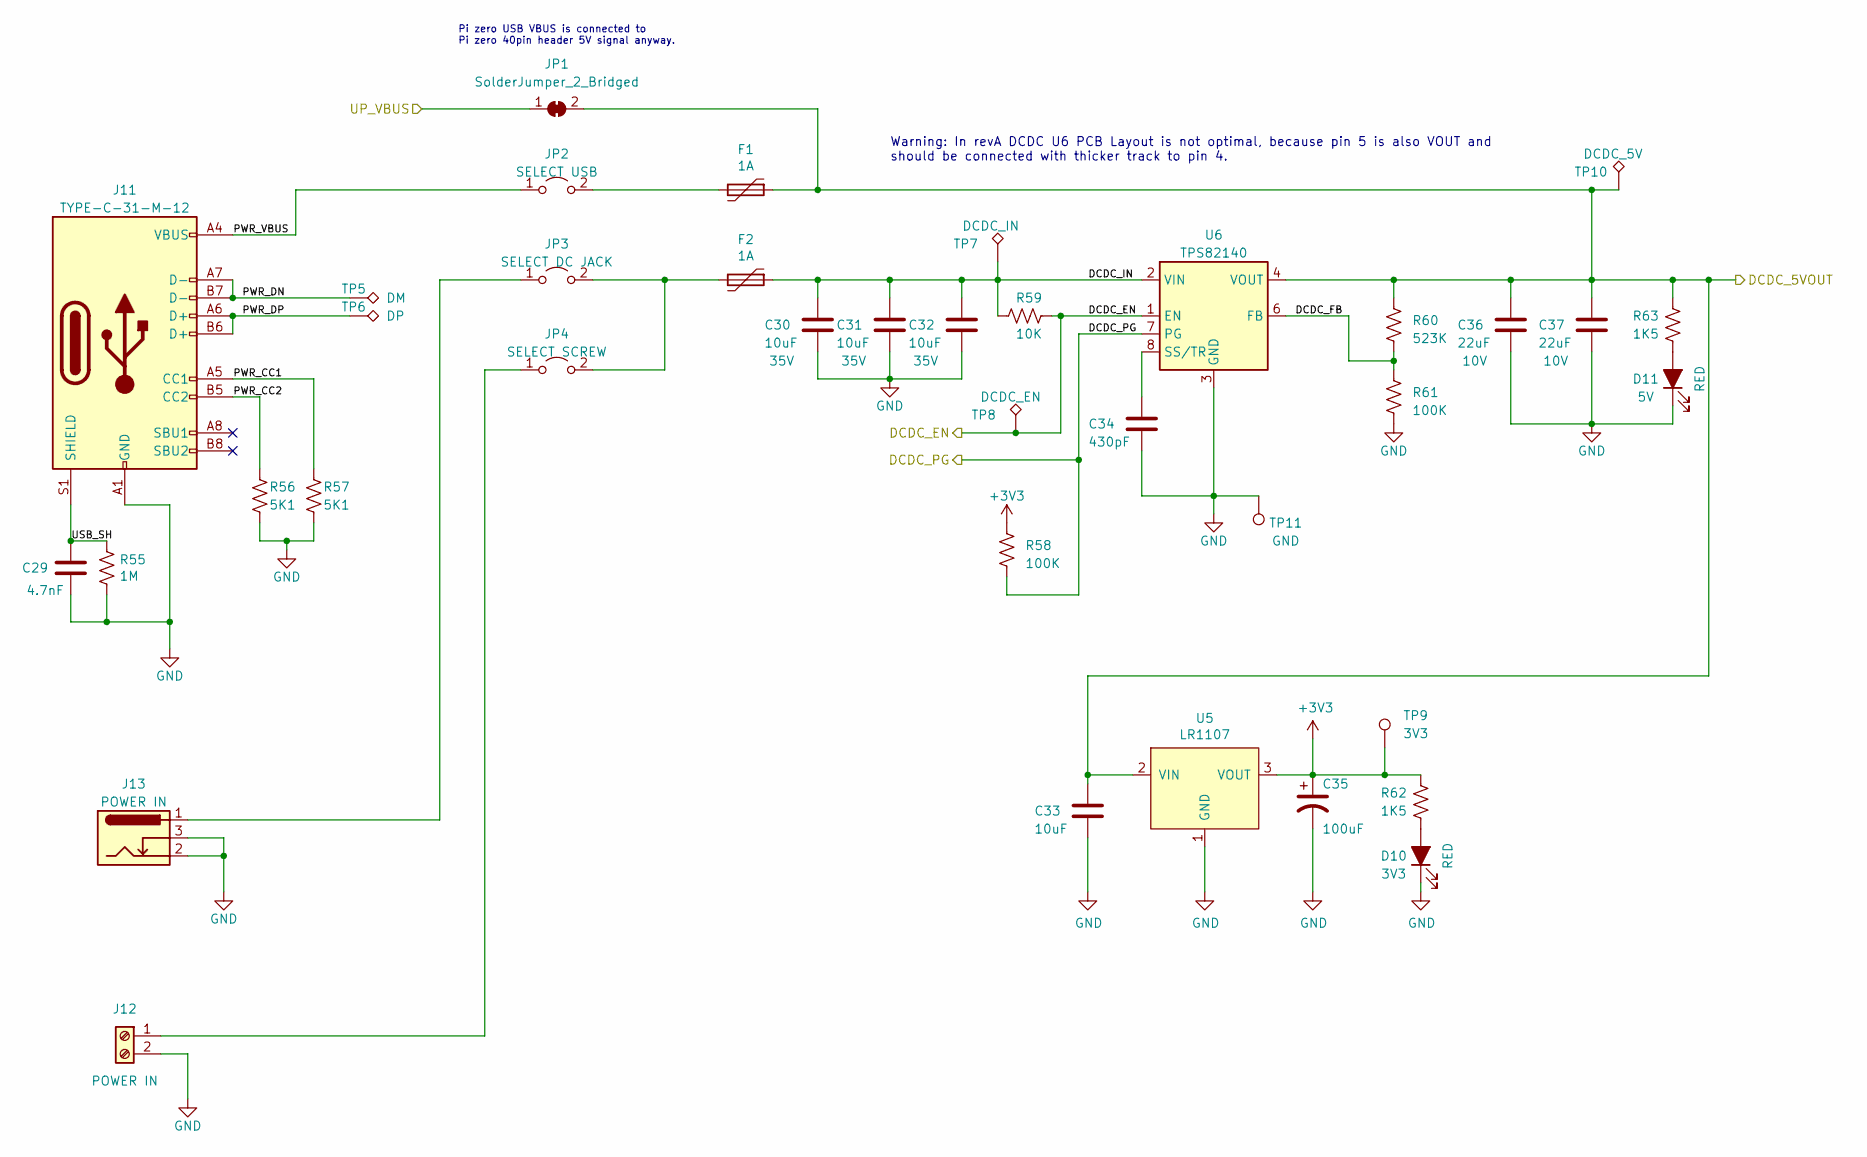
[picture p11: schematic power.kicad_sch, VoltHub7]

Parts:
C29: 4.7nF; C_1206_3216Metric; LCSC C107198
C30, C31, C32, C33: 10uF; C_0805_2012Metric; Voltage 35V; LCSC C162422
C34: 430pF; C_0603_1608Metric; LCSC C309472
C35: 100uF; CP_Elec_6.3x5.8; Voltage 10V; LCSC C340720
C36, C37: 22uF; C_0805_2012Metric; Voltage 10V; LCSC C29277
D10: 3V3; LED_0603_1608Metric; LCSC C193902
D11: 5V; LED_0603_1608Metric; LCSC C193902
F1, F2: 1A; Fuse_0805_2012Metric; LCSC C369152
J11: TYPE-C-31-M-12; USB_C_Receptacle_HRO_TYPE-C-31-M-12; LCSC C165948
J12: POWER IN; TerminalBlock_RND_205-00287_1x02_P5.08mm_Horizontal
J13: POWER IN; BarrelJack_CLIFF_FC681465S_SMT_Horizontal; LCSC C2987414
JP1: SolderJumper_2_Bridged; SolderJumper-2_P1.3mm_Bridged_RoundedPad1.0x1.5mm
JP2: SELECT USB; PinHeader_1x02_P2.54mm_Vertical
JP3: SELECT DC JACK; PinHeader_1x02_P2.54mm_Vertical
JP4: SELECT SCREW; PinHeader_1x02_P2.54mm_Vertical
R55: 1M; R_1206_3216Metric
R56, R57: 5K1; R_0603_1608Metric
R58, R61: 100K; R_0603_1608Metric; LCSC C25803
R59: 10K; R_0603_1608Metric; LCSC C25804
R60: 523K; R_0603_1608Metric; LCSC C5126197
R62: 1K5; R_0603_1608Metric; LCSC C21190
R63: 1K5; R_0603_1608Metric
TP5: DM; TestPoint_Pad_D1.0mm
TP6: DP; TestPoint_Pad_D1.0mm
TP7: DCDC_IN; TestPoint_Pad_D1.0mm
TP8: DCDC_EN; TestPoint_Pad_D1.0mm
TP9: 3V3; TestPoint_Pad_D1.0mm
TP10: DCDC_5V; TestPoint_Pad_D1.0mm
TP11: GND; TestPoint_Keystone_5019_Minature; LCSC C238131
U5: LR1107; SOT-89-3; LCSC C171498
U6: TPS82140; Texas_SIL0008D_MicroSiP-8-1EP_2.8x3mm_P0.65mm_EP1.1x1.9mm

Connections:
+3V3: C35.1, R58.2, R62.2, TP9.1, U5.3 (VOUT); also elsewhere on the board
+5V: C33.1, C36.1, C37.1, F1.1, JP1.2 (B), R60.2, R63.2, TP10.1, U5.2 (VIN), U6.4 (VOUT), U6.5 (VOUT); also elsewhere on the board
/DCDC_EN: R59.1, TP8.1, U6.1 (EN)
/DCDC_PG: R58.1, U6.7 (PG); also elsewhere on the board
/Power/DCDC_FB: R60.1, R61.2, U6.6 (FB)
/Power/DCDC_IN: C30.1, C31.1, C32.1, F2.1, R59.2, TP7.1, U6.2 (VIN)
/Power/PWR_CC1: J11.A5 (CC1), R57.2
/Power/PWR_CC2: J11.B5 (CC2), R56.2
/Power/PWR_DN: J11.A7 (D-), J11.B7 (D-), TP5.1
/Power/PWR_DP: J11.A6 (D+), J11.B6 (D+), TP6.1
/Power/PWR_VBUS: J11.A4 (VBUS), J11.A9 (VBUS), J11.B4 (VBUS), J11.B9 (VBUS), JP2.1 (A)
/Power/USB_SH: C29.1, J11.S1 (SHIELD), R55.1
/UP_VBUS: JP1.1 (A); also elsewhere on the board
GND: C29.2, C30.2, C31.2, C32.2, C33.2, C34.2, C35.2, C36.2, C37.2, D10.1 (K), D11.1 (K), J11.A1 (GND), J11.A12 (GND), J11.B1 (GND), J11.B12 (GND), J12.2, J13.2, J13.3, R55.2, R56.1, R57.1, R61.1, TP11.1, U5.1 (GND), U6.3 (GND), U6.9 (GND); also elsewhere on the board
unnamed: D10.2 (A), R62.1
unnamed: D11.2 (A), R63.1
unnamed: J12.1, JP4.1 (A)
unnamed: F1.2, JP2.2 (B)
unnamed: J13.1, JP3.1 (A)
unnamed: F2.2, JP3.2 (B), JP4.2 (B)
unnamed: C34.1, U6.8 (SS/TR)

Notes on the sheet:
Pi zero USB VBUS is connected to Pi zero 40pin header 5V signal anyway.
Warning: In revA DCDC U6 PCB Layout is not optimal, because pin 5 is also VOUT and should be connected with thicker track to pin 4.

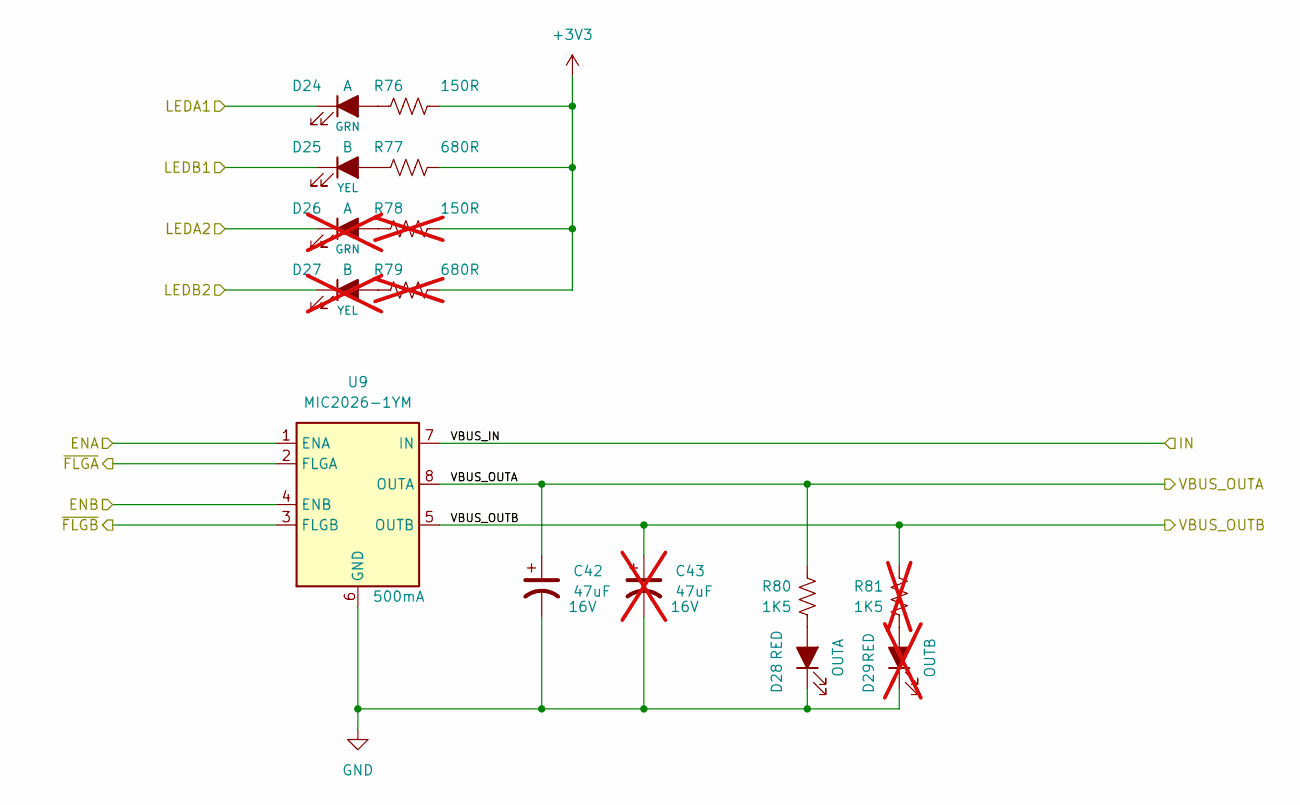
[picture p12: schematic downstream_port_last.kicad_sch, VoltHub7]

Parts:
C42: 47uF; CP_Elec_6.3x5.3; Voltage 16V; LCSC C249535
C43: 47uF; CP_Elec_6.3x5.3; Voltage 16V; LCSC C249535; not fitted
D24: A; LED_0603_1608Metric; LCSC C84267
D25: B; LED_0603_1608Metric; LCSC C84268
D26: A; LED_0603_1608Metric; LCSC C84267; not fitted
D27: B; LED_0603_1608Metric; LCSC C84268; not fitted
D28: OUTA; LED_0603_1608Metric; LCSC C193902
D29: OUTB; LED_0603_1608Metric; LCSC C193902; not fitted
R76: 150R; R_0603_1608Metric; LCSC C22808
R77: 680R; R_0603_1608Metric; LCSC C23228
R78: 150R; R_0603_1608Metric; LCSC C22808; not fitted
R79: 680R; R_0603_1608Metric; LCSC C23228; not fitted
R80: 1K5; R_0603_1608Metric
R81: 1K5; R_0603_1608Metric; not fitted
U9: MIC2026-1YM; SO-8_3.9x4.9mm_P1.27mm; LCSC C144190

Connections:
+3V3: R76.2, R77.2, R78.2, R79.2; also elsewhere on the board
+5V: U9.7 (IN); also elsewhere on the board
/LEDA7: D24.1 (K); also elsewhere on the board
/LEDB7: D25.1 (K); also elsewhere on the board
/OCS7: U9.2 (FLGA); also elsewhere on the board
/PRTPWR7: U9.1 (ENA); also elsewhere on the board
/Port4 down1/ENB: U9.4 (ENB); also elsewhere on the board
/Port4 down1/VBUS_OUTB: C43.1, R81.2, U9.5 (OUTB)
/Port4 down1/~FLGB: U9.3 (FLGB)
/VBUS7: C42.1, R80.2, U9.8 (OUTA); also elsewhere on the board
GND: C42.2, C43.2, D28.1 (K), D29.1 (K), U9.6 (GND); also elsewhere on the board
unnamed: D24.2 (A), R76.1
unnamed: D25.2 (A), R77.1
unnamed: D26.2 (A), R78.1
unnamed: D27.2 (A), R79.1
unnamed: D28.2 (A), R80.1
unnamed: D29.2 (A), R81.1
