voltlog/VoltHub7/volthub7.kicad_pcb

## KiCad design volthub7.kicad_pcb (continued)

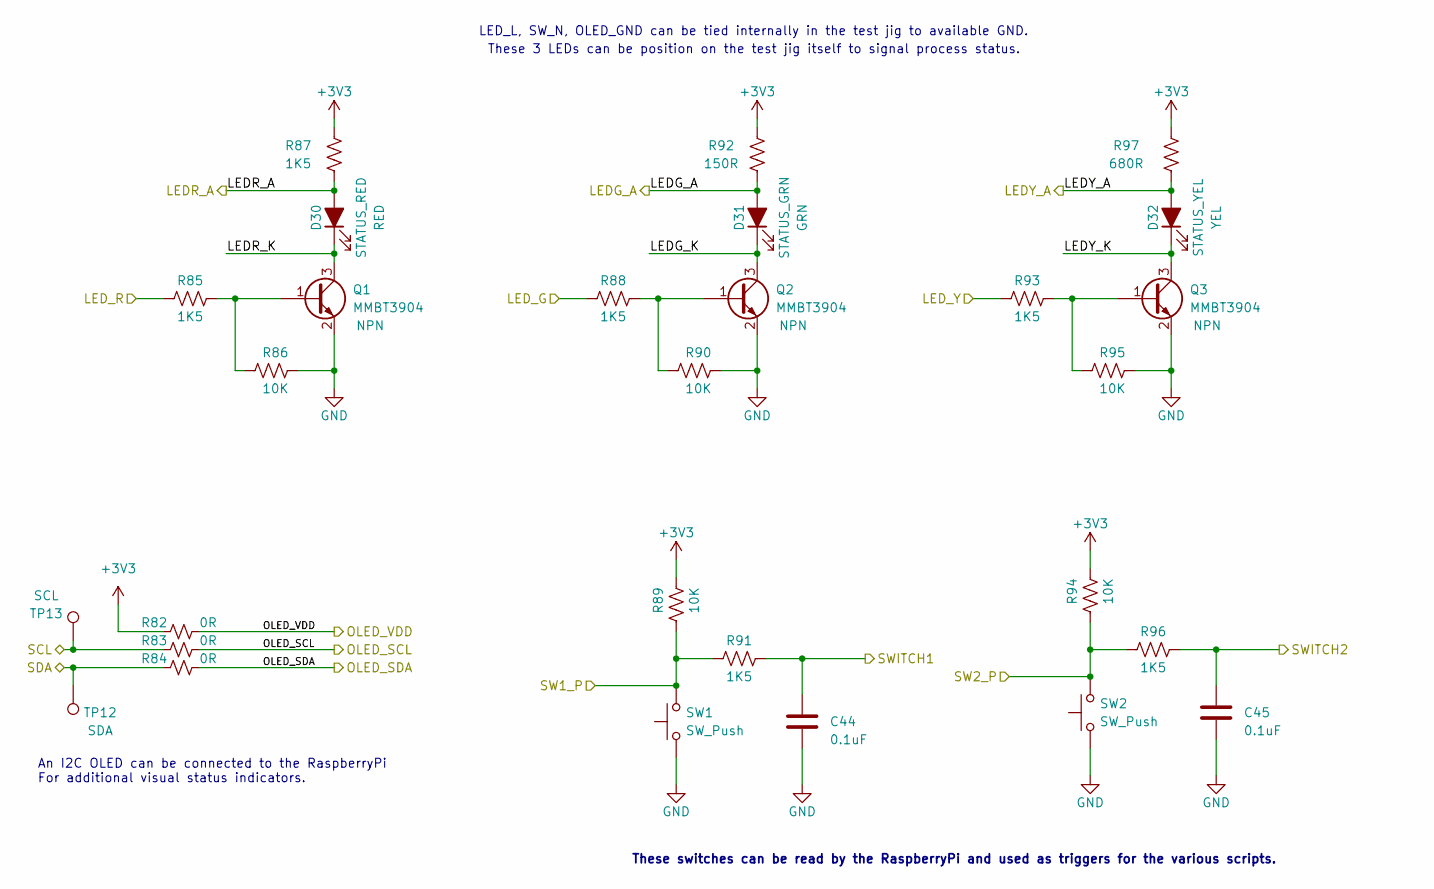
[picture p13: schematic output.kicad_sch, VoltHub7]

Parts:
C44, C45: 0.1uF; C_0603_1608Metric; LCSC C14663
D30: STATUS_RED; LED_0603_1608Metric; LCSC C193902
D31: STATUS_GRN; LED_0603_1608Metric; LCSC C84267
D32: STATUS_YEL; LED_0603_1608Metric; LCSC C84268
Q1, Q2, Q3: MMBT3904; SOT-23; LCSC C20526
R82, R83, R84: 0R; R_0603_1608Metric; LCSC C21189
R85, R87, R88, R91, R93, R96: 1K5; R_0603_1608Metric; LCSC C21190
R86, R89, R90, R94, R95: 10K; R_0603_1608Metric; LCSC C25804
R92: 150R; R_0603_1608Metric; LCSC C22808
R97: 680R; R_0603_1608Metric; LCSC C23228
SW1, SW2: SW_Push; SW_SPST_Omron_B3FS-100xP
TP12: SDA; TestPoint_Pad_D1.0mm
TP13: SCL; TestPoint_Pad_D1.0mm

Connections:
+3V3: R82.1, R87.1, R89.1, R92.2, R94.1, R97.2; also elsewhere on the board
/GPIO18: C45.1, R96.1; also elsewhere on the board
/LEDG_A: D31.2 (A), R92.1; also elsewhere on the board
/LEDR_A: D30.2 (A), R87.2; also elsewhere on the board
/Output/LEDG_K: D31.1 (K), Q2.3 (C)
/Output/LEDR_K: D30.1 (K), Q1.3 (C)
/Output/LEDY_A: D32.2 (A), R97.1; also elsewhere on the board
/Output/LEDY_K: D32.1 (K), Q3.3 (C)
/Output/LED_G: R88.2; also elsewhere on the board
/Output/LED_R: R85.2; also elsewhere on the board
/Output/LED_Y: R93.2; also elsewhere on the board
/Output/OLED_SCL: R83.2; also elsewhere on the board
/Output/OLED_SDA: R84.2; also elsewhere on the board
/Output/OLED_VDD: R82.2; also elsewhere on the board
/Output/SW1_P: R89.2, R91.2, SW1.2; also elsewhere on the board
/Output/SW2_P: R94.2, R96.2, SW2.2; also elsewhere on the board
/Output/SWITCH1: C44.1, R91.1; also elsewhere on the board
/SCL/CFG_SEL0: R83.1, TP13.1; also elsewhere on the board
/SDA: R84.1, TP12.1; also elsewhere on the board
GND: C44.2, C45.2, Q1.2 (E), Q2.2 (E), Q3.2 (E), R86.1, R90.1, R95.1, SW1.1, SW2.1; also elsewhere on the board
unnamed: Q1.1 (B), R85.1, R86.2
unnamed: Q2.1 (B), R88.1, R90.2
unnamed: Q3.1 (B), R93.1, R95.2

Notes on the sheet:
These switches can be read by the RaspberryPi and used as triggers for the various scripts.
LED_L, SW_N, OLED_GND can be tied internally in the test jig to available GND.
An I2C OLED can be connected to the RaspberryPi For additional visual status indicators.
These 3 LEDs can be position on the test jig itself to signal process status.

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
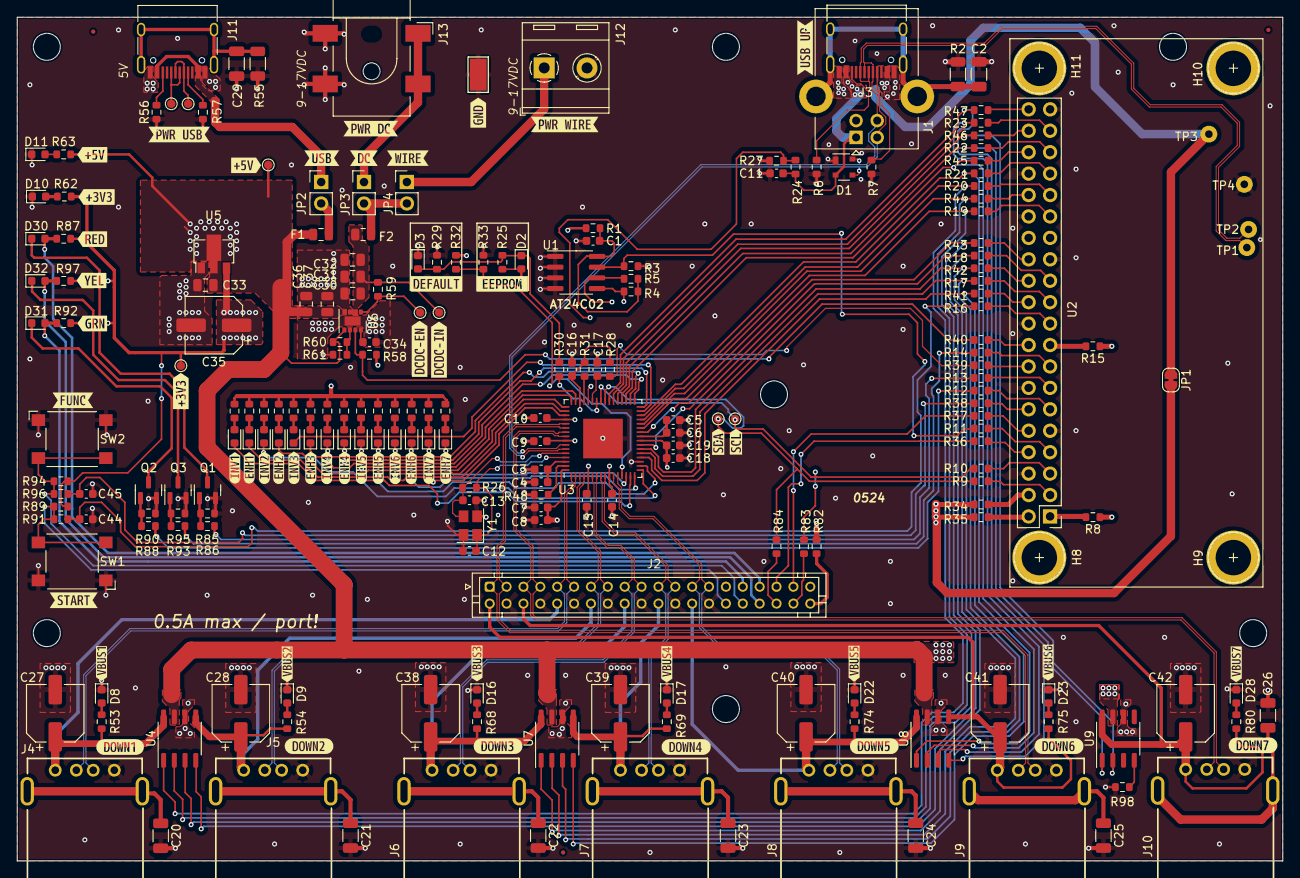
[picture p14: board volthub7.kicad_pcb from above]

Board: 4 copper layers, 150.0 x 100.0 mm, 281 parts (0 on the bottom side), 168 nets.

Other parts of the board:
C2: 4.7nF; C_1206_3216Metric
kibuzzard-65BCE967: G***; kibuzzard-65BCE967
kibuzzard-65BCEA26: G***; kibuzzard-65BCEA26
kibuzzard-65BCEB9B: G***; kibuzzard-65BCEB9B
kibuzzard-65BCEB17: G***; kibuzzard-65BCEB17
kibuzzard-65BCEB28: G***; kibuzzard-65BCEB28
kibuzzard-65BCEB39: G***; kibuzzard-65BCEB39
kibuzzard-65BCEB78: G***; kibuzzard-65BCEB78
kibuzzard-65BCEB84: G***; kibuzzard-65BCEB84
kibuzzard-65BCEBAB: G***; kibuzzard-65BCEBAB
kibuzzard-65BCEBCC: G***; kibuzzard-65BCEBCC
kibuzzard-65BCEBF9: G***; kibuzzard-65BCEBF9
kibuzzard-65BCEC24: G***; kibuzzard-65BCEC24
kibuzzard-65BCEC45: G***; kibuzzard-65BCEC45
kibuzzard-65BCEC76: G***; kibuzzard-65BCEC76
kibuzzard-65BCECFE: G***; kibuzzard-65BCECFE
kibuzzard-65BCED0C: G***; kibuzzard-65BCED0C
kibuzzard-65BCED07: G***; kibuzzard-65BCED07
kibuzzard-65BCED15: G***; kibuzzard-65BCED15
kibuzzard-65BCED99: G***; kibuzzard-65BCED99
kibuzzard-65BCEDAD: G***; kibuzzard-65BCEDAD
kibuzzard-65BCEDE4: G***; kibuzzard-65BCEDE4
kibuzzard-65BCEF9B: G***; kibuzzard-65BCEF9B
kibuzzard-65BCEF96: G***; kibuzzard-65BCEF96
kibuzzard-65BCEFA3: G***; kibuzzard-65BCEFA3
kibuzzard-65BCEFA7: G***; kibuzzard-65BCEFA7
kibuzzard-65BCEFAC: G***; kibuzzard-65BCEFAC
kibuzzard-65BCEFB2: G***; kibuzzard-65BCEFB2
kibuzzard-65BCEFB9: G***; kibuzzard-65BCEFB9
kibuzzard-65BCEFD7: G***; kibuzzard-65BCEFD7
kibuzzard-65BCEFE1: G***; kibuzzard-65BCEFE1
kibuzzard-65BCEFE6: G***; kibuzzard-65BCEFE6
kibuzzard-65BCEFEA: G***; kibuzzard-65BCEFEA
kibuzzard-65BCEFEF: G***; kibuzzard-65BCEFEF
kibuzzard-65BCEFF4: G***; kibuzzard-65BCEFF4
kibuzzard-65BCEFF8: G***; kibuzzard-65BCEFF8
kibuzzard-65BCF0AF: G***; kibuzzard-65BCF0AF
kibuzzard-65BCF2C7: G***; kibuzzard-65BCF2C7
kibuzzard-65BCF2D0: G***; kibuzzard-65BCF2D0
kibuzzard-65BCF08A: G***; kibuzzard-65BCF08A
kibuzzard-65BCF09D: G***; kibuzzard-65BCF09D
kibuzzard-65BCF34D: G***; kibuzzard-65BCF34D
kibuzzard-65BCF35A: G***; kibuzzard-65BCF35A
kibuzzard-65BCF37C: G***; kibuzzard-65BCF37C
kibuzzard-65BCF060: G***; kibuzzard-65BCF060
kibuzzard-65BCF085: G***; kibuzzard-65BCF085
kibuzzard-65BCF092: G***; kibuzzard-65BCF092
kibuzzard-65BCF099: G***; kibuzzard-65BCF099
kibuzzard-65BCF323: G***; kibuzzard-65BCF323
kibuzzard-65BCF353: G***; kibuzzard-65BCF353
kibuzzard-65BCF360: G***; kibuzzard-65BCF360
kibuzzard-65BCF377: G***; kibuzzard-65BCF377

Their connections:
GND: C2.2; also elsewhere on the board
