voltlog/VoltHub7/(commit log)

2024-01-26 started schematic capture
    [downstream_port.kicad_sch, volthub7.kicad_pcb, volthub7.kicad_sch]
2024-02-27 public release revA
    [downstream_port.kicad_sch, downstream_port_last.kicad_sch, output.kicad_sch, power.kicad_sch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]
