voltlog/VoltHub7/(notices)

Notices in the files:
output.kicad_sch:
License GPLv3
